ItIsNotImportant-02/VMix-Replay-Controller/docs/layout/evs-lsm-reference-photo.jpg

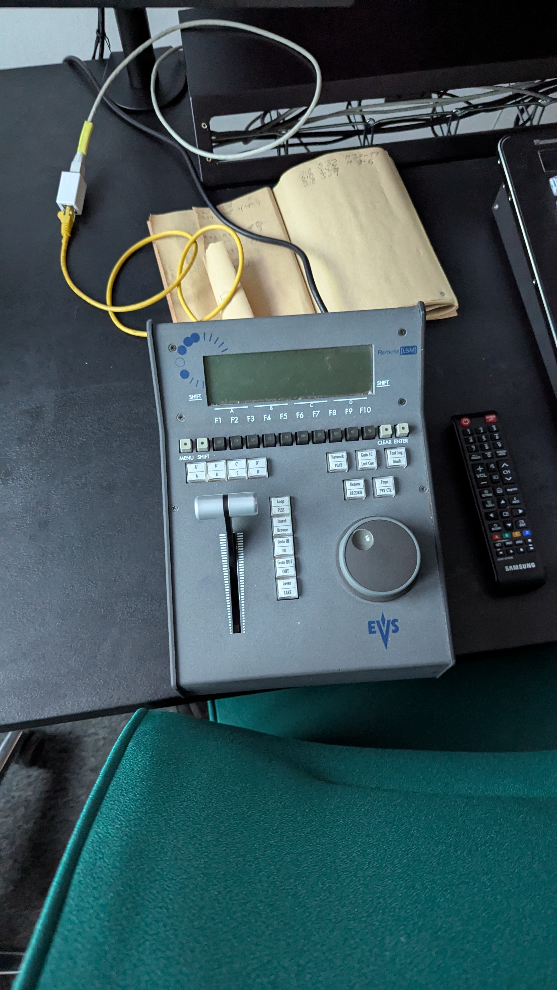
docs/layout/evs-lsm-reference-photo.jpg
