ItIsNotImportant-02/VMix-Replay-Controller/README.md

# vMix Replay Controller

Vlastní hardwarový ovladač pro vMix Replay ve stylu EVS: RGB tlačítka, páka pro rychlost, jog kolečko. Vlastní PCB (KiCad, osazení JLCPCB), vlastní firmware, 3D tištěná krabička.

- Plán projektu: [docs/PLAN.md](docs/PLAN.md)
- Dashboard postupu: https://claude.ai/artifact/F6eHfhQ5NSxDFNfWmzDA3g
- Deep Research prompty: [docs/research/](docs/research/)
