ItIsNotImportant-02/VMix-Replay-Controller/mechanics/README.md

# Mechanika

3D modely krabičky, mechanismu páky a jogu (STEP/STL), krok 9.x.
