ItIsNotImportant-02/VMix-Replay-Controller/firmware/README.md

# Firmware

Firmware pro RP2040 (W5500, IS31FL3236A, TCA9555, MT6701). Zatím prázdné; začne se prototypem na W5500-EVB-Pico (krok 7.1).
