ItIsNotImportant-02/VMix-Replay-Controller/docs/research/DR3-report-gemini.md

# **Advanced Hardware Architecture for a USB-C Broadcast Replay Controller**

## **Executive Summary**

The engineering of a broadcast-grade replay controller necessitates a rigorous focus on component latency, tactile feedback, signaling integrity, and strict power constraints. Operating within a strict 500 mA, 5 V USB-C power budget while driving \~45 independent LED channels, processing high-resolution quadrature feedback, and maintaining reliable TCP communication over Ethernet demands a highly optimized and mathematically verified hardware architecture.  
Based on extensive component analysis and the specific manufacturing capabilities of the JLCPCB Surface Mount Technology (SMT) assembly ecosystem, this report establishes a comprehensive design methodology for the printed circuit board (PCB) assembly. The recommended architecture leverages the Raspberry Pi RP2040 microcontroller1 for its maturity and predictable silicon behavior, intentionally bypassing the newer RP2350 due to unresolved hardware errata affecting GPIO inputs3. Ethernet connectivity is managed by the WIZnet W5500 over an 80 MHz SPI bus5, terminating in a HanRun HR911105A integrated magnetic RJ45 jack6 to minimize electromagnetic interference (EMI).  
For the human-machine interface, two ISSI IS31FL3236A constant-current LED drivers manage the common-anode RGB switches7, actively avoiding the camera-flicker and banding issues inherent in matrix-multiplexed topologies. Switch states are acquired via a TCA9555 I2C I/O expander, utilizing hardware interrupts to eliminate polling overhead and preserve CPU cycles8. Both the replay lever and the jog wheel employ the MT6701 contactless magnetic angle sensor10, providing 14-bit absolute accuracy and high-resolution ABZ quadrature outputs, drastically outperforming traditional optical encoders and the slower AS560011. Power is regulated by a robust AMS1117-3.3 linear low-dropout (LDO) regulator13, with the design strictly adhering to JLCPCB "Basic" and "Promotional Extended" components wherever possible to minimize feeder loading fees14.

## **1\. Microcontroller Subsystem: RP2040 vs. RP2350 Architecture**

The selection of the primary microcontroller unit (MCU) dictates the foundational architecture, software stack, peripheral allocation, and routing topology of the entire controller board. While both the Raspberry Pi RP2040 and its successor, the RP2350, offer exceptional Programmable I/O (PIO) capabilities, their silicon maturity, layout requirements, and current hardware bugs differ significantly.

### **1.1 Architectural and Performance Comparison**

The RP2040 (LCSC C2040) is a mature, dual-core ARM Cortex-M0+ processor operating at 133 MHz, equipped with 264 KB of SRAM2. It has been heavily adopted across the industry and is widely available at JLCPCB as a "Basic" component, meaning it incurs no \$3.07 feeder loading fee during assembly14.  
Conversely, the RP2350 (LCSC C39843328 for the QFN-80 package) offers a significant performance leap, featuring a dual-core Cortex-M33 architecture with an optional Hazard3 RISC-V core execution mode at 150 MHz1. The RP2350 doubles the internal SRAM to 520 KB and introduces a hardware Floating-Point Unit (FPU) alongside DSP-oriented instructions2. Both microcontrollers lack internal non-volatile application flash memory, necessitating an external Quad-SPI (QSPI) flash chip for code execution17.

| Feature / Specification | RP2040 (C2040) | RP2350 (C39843328) |
| :---- | :---- | :---- |
| **CPU Architecture** | Dual Cortex-M0+ @ 133 MHz | Dual Cortex-M33 / Hazard3 RISC-V @ 150 MHz |
| **Internal SRAM** | 264 KB | 520 KB |
| **Hardware FPU/DSP** | None (Software accelerated) | Single-precision FPU, DSP extensions |
| **Programmable I/O (PIO)** | 2 blocks, 8 state machines | 3 blocks, 12 state machines |
| **Advanced Security** | Basic | TrustZone, Secure Boot, OTP, TRNG |
| **JLCPCB Classification** | Basic (Highly Stocked, No Fee) | Extended (Subject to stock and \$3.07 fee) |
| **Silicon Maturity & Risk** | Fully patched, mature ecosystem | Susceptible to E9 GPIO Latching Erratum |

### **1.2 The E9 Erratum and Hardware Implications**

Despite the RP2350's superior computational headroom, early silicon revisions (including the A2 stepping) exhibit a critical hardware flaw documented as Erratum E93. This erratum involves increased leakage current when Bank 0 GPIO pads are enabled as digital inputs. The internal pull-down resistors (approximately 50 k$\Omega$) are too weak to overcome this leakage current, causing the pad voltage to artificially latch at approximately 2.0 V to 2.2 V4.  
For a broadcast controller reading numerous high-impedance switches, limit sensors, and external interrupts, reliable input states are mandatory. The E9 erratum forces hardware designers to either implement aggressive software workarounds—such as continuously toggling the GPIO input enable (IE) bit, temporarily disabling interrupts, and halting FreeRTOS task switching during every digital read—or to populate external physical pull-down resistors of 8.2 k$\Omega$ or lower on every affected input pin4.  
If the RP2350 were selected for this design, adding external pull-down resistors for the \~20 switch inputs and encoder channels would significantly increase the Bill of Materials (BOM) count, consume valuable PCB real estate, and inflate assembly costs.

### **1.3 External QSPI Flash and Support Circuitry**

Both MCUs execute code in place (XIP) via an external QSPI flash memory. The Winbond W25Q128JVSIQ (LCSC C97521) is an optimal choice, providing 128 Mbit (16 MB) of storage and supporting up to 133 MHz clock speeds25. To ensure stable boot sequences, a 10 k$\Omega$ pull-up resistor is required on the QSPI\_SS pin to prevent the MCU from dropping into USB mass storage bootloader mode erratically21.  
Timing accuracy for USB communication and PIO state machines relies on an external 12 MHz crystal oscillator (3225 package format, with 12 pF to 18 pF load capacitance)26.

### **1.4 Power Supply Topologies (LDO vs. Internal Regulators)**

The power supply architecture differs fundamentally between the two chips. The RP2040 features a built-in linear regulator that accepts 3.3 V and outputs the 1.1 V required for the internal digital core (DVDD)21. The RP2350, however, features a more complex five-pin internal switched-mode/linear regulator subsystem that requires specific external componentry, or alternatively, entirely bypassing it in favor of an external 1.1 V buck converter21.

### **1.5 Recommendation for Late 2026**

For a commercial design entering manufacturing in late 2026, the **RP2040 is the unequivocally recommended MCU**. The broadcast controller's processing requirements—primarily TCP offloading to the W5500, I2C polling, and PIO-based ABZ quadrature tracking—do not require Cortex-M33 DSP instructions or 520 KB of RAM. The RP2040 is a JLCPCB Basic part, guarantees predictable silicon behavior, avoids the BOM-bloat associated with the E9 erratum, and utilizes highly documented KiCad hardware minimal design references17.

## **2\. Ethernet Subsystem: WIZnet W5500 Integration**

Broadcast replay systems typically interface with software (such as vMix) or hardware switchers via local area networks. Reliable, low-latency TCP communication is mandatory. Relying on an MCU to handle software TCP/IP stacks (like lwIP) often introduces unpredictable latency spikes under heavy packet loads.

### **2.1 W5500 Architecture and SPI Direct Memory Access**

The WIZnet W5500 (LCSC C32843) is a hardwired TCP/IP embedded Ethernet controller that provides internet connection to embedded systems by utilizing a highly efficient Serial Peripheral Interface (SPI)27. It encapsulates the entire OSI model transport and network layers in silicon, supporting TCP, UDP, IPv4, ICMP, ARP, IGMP, and PPPoE27. It includes 32 KB of internal static RAM allocated for TX/RX buffering and supports up to 8 independent hardware sockets simultaneously27.  
Offloading the TCP/IP stack to the W5500 frees the RP2040 from managing packet fragmentation, ARP resolution, and TCP handshakes30. The SPI interface on the W5500 supports theoretical clock speeds up to 80 MHz5. To achieve minimal latency on TCP port 8099 (the standard communication port for vMix and similar broadcast APIs), the RP2040 should communicate with the W5500 using Direct Memory Access (DMA) over the SPI bus. Utilizing the RP2040's PIO state machines to drive the SPI interface further eliminates CPU bottlenecking during large packet transfers31.

### **2.2 RJ45 Magjack Integration**

Instead of routing discrete Ethernet transformers—which consume excessive PCB real estate and demand rigorous EMI shielding techniques—an integrated RJ45 magjack is highly recommended. The HanRun HR911105A (LCSC C12074) integrates the 1:1 isolation transformers, common-mode chokes, and link/activity LEDs required for 10/100Base-TX Ethernet directly into the connector housing6.

| Component Category | Recommended Part | LCSC Number | JLCPCB Classification | Estimated Function / Benefit |
| :---- | :---- | :---- | :---- | :---- |
| **Ethernet Controller** | WIZnet W5500 | C32843 | Extended | Hardwired TCP/IP, 32KB Buffer, 80MHz SPI |
| **Integrated Magjack** | HanRun HR911105A | C12074 | Extended | Built-in isolation magnetics, saves PCB space |
| **Clock Source** | 25.000 MHz Crystal | C521599 (varies) | Basic | Required for W5500 PHY PLL timing |
| **Termination Resistors** | 49.9  1% Resistors | Generic 0603/0402 | Basic | RX/TX pair impedance matching |

### **2.3 PCB Layout Guidelines and 100-Ohm Differential Impedance**

The physical layer (PHY) layout between the W5500 and the HR911105A is the most critical routing task on the board to ensure packet integrity. The Ethernet standard specifies a 100  differential impedance for the transmit (TX) and receive (RX) pairs33.

* **Routing Topology:** The differential pairs (TXP/TXN and RXP/RXN) must be routed symmetrically, edge-coupled, and strictly length-matched35. Any mismatch in trace length introduces phase shifts that degrade the differential signal into common-mode noise. Acute routing angles (less than 135 degrees) must be avoided to prevent signal reflection35.  
* **Reference Plane:** A solid, uninterrupted ground plane must exist directly beneath the entire length of the differential pairs on the adjacent internal or bottom layer to provide a predictable, low-impedance return path35.  
* **Clearance and Crosstalk:** Maintain a clearance of at least three times the inter-pair spacing (the "3W rule")—ideally 5X—between the Ethernet pairs and any high-speed digital lines (e.g., the SPI bus or QSPI traces) to prevent capacitive coupling and crosstalk35.  
* **Center Tap Filtering:** The W5500 PHY requires specific termination passive networks. The center tap of the RJ45 magnetics must be decoupled to ground via a 0.1 F capacitor, and the TX/RX pairs require 49.9  (1% tolerance) pull-up resistors to the 3.3 V analog supply rail (AVDD) to dissipate common-mode noise37.  
* **Clock Isolation:** The 25 MHz crystal required to drive the W5500's internal phase-locked loop (PLL) must be placed as close to the XTAL pins as possible. A dedicated ground guard ring should surround the crystal circuitry to prevent the 25 MHz fundamental frequency and its harmonics from coupling into the sensitive analog PHY traces38.

## **3\. Broadcast Tactile Interface: LED Driving Topology**

A replay controller relies heavily on visual feedback; buttons must illuminate brightly to indicate active cameras, recording states, and transition readiness. Driving \~15 SPDT push buttons featuring common-anode RGB LEDs results in \~45 discrete LED channels. The 5 V, 500 mA power budget strictly governs the driving topology and efficiency requirements.

### **3.1 Multiplexing vs. Constant-Current Direct Drive**

Traditional approaches to driving high-channel-count LEDs involve matrix multiplexing (e.g., IS31FL3731, IS31FL3741) or simple shift registers combined with current-limiting resistors (e.g., 74HC595). However, broadcast environments involve high-framerate, rolling-shutter cameras under studio lighting. Matrix multiplexing inherently relies on scanning rows and columns sequentially; if this scanning frequency beats against a broadcast camera's shutter speed or refresh rate, severe dark banding or flickering will be visible on the video feed.  
Furthermore, relying on simple shift registers with series resistors (or a PCA9685 paired with 45 external discrete transistors) results in massive BOM bloat, exorbitant assembly costs, and uneven brightness. Forward voltage () variations across different LED color batches mean that fixed resistors will yield unpredictable luminous intensity.  
A direct-drive, constant-current PWM topology is essential. Every LED cathode must be driven by a dedicated, unmultiplexed current sink operating at a high PWM frequency.

### **3.2 Component Comparison: LED Drivers**

| Driver IC | Topology | Channels | Interface | PWM Frequency / Resolution | Viability for Broadcast |
| :---- | :---- | :---- | :---- | :---- | :---- |
| **IS31FL3731/3741** | Matrix Multiplexed | 144 / 351 | I2C | Variable / 8-bit | **Poor:** Causes camera banding/flicker. |
| **74HC595 \+ Resistors** | Direct Voltage | 8 | SPI | Bit-banged MCU | **Poor:** 100% CPU usage, uneven brightness. |
| **PCA9685 \+ Transistors** | Direct Voltage | 16 | I2C | 1.5 kHz / 12-bit | **Poor:** Requires 45 external MOSFETs. |
| **TLC5947 / TLC5955** | Direct Constant Current | 24 / 48 | SPI | High / 12-bit to 16-bit | **Moderate:** High cost, often low stock at JLCPCB. |
| **IS31FL3236A** | Direct Constant Current | 36 | I2C | 22 kHz / 8-bit | **Excellent:** No flicker, minimal passives. |

### **3.3 The IS31FL3236A Architecture**

The ISSI IS31FL3236A (LCSC C246443) is the optimal choice for this architecture. It provides 36 independent constant-current channels, each with 8-bit (256-step) independent PWM duty-cycle control7. Most critically, the PWM frequency can be hard-set to 22 kHz, placing it well outside the audible spectrum (preventing ceramic capacitor "singing") and completely eliminating camera flicker, regardless of the camera's shutter angle7.  
To support 45 channels, two IS31FL3236A ICs are required in parallel (yielding a total capacity of 72 channels)7. Both ICs share the same I2C bus. The 7-bit I2C slave address is hardware-configured via the AD pin. Connecting the AD pin of IC1 to GND configures it to address 0x78, and connecting the AD pin of IC2 to VCC configures it to 0x7E7.

### **3.4 Thermal Dissipation and Efficiency Calculations**

Power dissipation within the LED driver is a direct function of the voltage drop across the internal constant-current sinks. The RGB LEDs possess differing forward voltages based on semiconductor bandgaps:

* Red LEDs:   
* Green/Blue LEDs: 

Given that the common anodes are tied directly to the 5.0 V USB VBUS supply (to avoid overloading the 3.3 V LDO), the driver IC must sink the remaining voltage internally to maintain constant current:

* Red Voltage Drop:   
* Green/Blue Voltage Drop: 

Assuming a conservative design target of 10 mA per color channel (which yields excellent brightness for modern LEDs without blinding the operator), the thermal power dissipation () per IC can be estimated. Assuming the 45 LEDs are split evenly (22 channels on IC1, 23 on IC2), IC1 will drive approximately 7 Red, 7 Green, and 8 Blue channels.   Total  per driver IC41.  
The QFN-44 (5x5 mm) package utilizes a large exposed thermal pad. To safely dissipate \~0.5 W and maintain junction temperatures well below the 125 °C absolute maximum, the PCB layout must feature a solid copper ground pour directly beneath the IC. This pad must be stitched with a 3x3 grid of thermal vias connecting the top layer to the internal and bottom ground planes, creating a highly efficient thermal exhaust path42.  
The global output current ceiling is established via a single external resistor () on pin 40\. According to the datasheet formula , selecting an  of 7.6 k$\Omega$ sets the maximum possible per-channel current to a safe 10 mA, ensuring that software bugs cannot accidentally command 38 mA and melt the plastic button housings40.

## **4\. Switch Acquisition and Debounce Strategy**

Reading 15 SPDT push buttons (utilizing the Common and Normally Open terminals), alongside auxiliary switches on the T-bar lever and jog wheel, requires tracking approximately 18 to 20 digital inputs.

### **4.1 Topology Comparison: GPIO, Matrix, and Expanders**

> 1. **Direct GPIO:** Connecting 20 switches directly to the RP2040 requires 20 pins. This exhausts the RP2040's GPIO budget, leaving insufficient pins for the QSPI flash, Ethernet SPI bus, I2C buses, and PIO encoder reading.  
> 2. **Diode Matrix:** A matrix reduces pin count (e.g., a 4x5 matrix requires only 9 pins) but demands 20 individual switching diodes (e.g., 1N4148W) to prevent ghosting when multiple buttons are pressed simultaneously44. This significantly inflates the BOM line items and JLCPCB assembly costs, while still requiring the CPU to continuously scan the matrix45.  
> 3. **Shift Registers:** The 74HC165 (LCSC C80696) is highly affordable and categorized as a Basic part46. However, shift registers lack interrupt capabilities. They require continuous CPU polling over SPI or bit-banging, wasting RP2040 cycles and introducing variable input latency.  
> 4. **I/O Expander:** I2C I/O expanders like the MCP23017 or TCA9555 offer 16 bits of remote I/O with dedicated hardware interrupt outputs8.

| Input Topology | Pin Count Required | CPU Overhead | Hardware Interrupt | JLCPCB Assembly Impact |
| :---- | :---- | :---- | :---- | :---- |
| **Direct GPIO** | 20 | Low | Yes | None (uses native MCU) |
| **Diode Matrix** | 9 | High (Constant scanning) | No | High (Adds 20 diodes to BOM) |
| **74HC165 Shift Register** | 4 (SPI) | High (Constant polling) | No | Low (Basic Part) |
| **TCA9555 I/O Expander** | 2 (I2C) \+ 1 (INT) | Very Low (Event-driven) | Yes | Moderate (Extended Part) |

### **4.2 The TCA9555 Interrupt Architecture**

The TCA9555 (LCSC C140277) is the superior architectural choice. By utilizing two TCA9555 ICs on the same I2C bus, 32 inputs are secured. The critical advantage of the TCA9555 is its hardware interrupt (INT) pin. The IC automatically drives the INT pin low whenever any input state changes across its ports8.  
Consequently, the RP2040 can remain completely idle regarding switch polling. It only initiates an I2C read when the hardware interrupt triggers, ensuring sub-millisecond reaction times to button presses—a strict necessity for a live broadcast controller triggering rapid video cuts9.  
Mechanical switches inherently exhibit contact bounce, which can last between 5 ms and 20 ms. While hardware RC filters (e.g., a 10 k$\Omega$ pull-up and a 100 nF capacitor to ground) provide perfect analog debouncing, they add 40 passive components to the BOM. A more efficient approach utilizes robust software debouncing algorithms within the RP2040 firmware, utilizing a non-blocking delayed-on/off state machine that filters any transitions faster than 15 ms49.

## **5\. Precision Lever Angle Sensing (T-Bar)**

Broadcast replay controllers utilize a heavily damped lever (often referred to as a T-bar) to control playback speed (e.g., from 0% to 100% slow motion). Historically, these relied on high-end carbon track potentiometers, which inevitably degrade over time due to mechanical friction. Contactless magnetic Hall-effect sensors provide infinite mechanical life and superior linearity.

### **5.1 Magnetic Sensor Comparison**

The two dominant market options for absolute magnetic angle sensing are the AMS AS5600 (LCSC C499458)11 and the MagnTek MT6701 (LCSC C3003196)50.

| Specification | AS5600 | MT6701 |
| :---- | :---- | :---- |
| **Technology** | Standard Hall-Effect | Differential Hall-Effect |
| **Resolution** | 12-bit (4,096 steps) | 14-bit (16,384 steps) |
| **Digital Interfaces** | I2C, PWM | I2C, SSI, ABZ Quadrature, PWM |
| **System Latency** | \~1.5 ms (I2C bound) | \< 5 s (Analog/SSI bound) |
| **Maximum Speed** | Limited | 55,000 RPM |
| **JLCPCB Cost (Est.)** | \~\$1.20 | \~\$0.76 |

While the AS5600 is ubiquitous in hobbyist applications, its 12-bit resolution and high I2C latency make it unsuitable for smooth, broadcast-grade interpolation11. Furthermore, multiple AS5600s share the exact same hardcoded I2C address, requiring hardware multiplexers if more than one is used on a bus52.  
The MT6701 calculates the absolute angle by utilizing two interleaved Wheatstone bridges mapped to an internal DSP unit, achieving a sub-5 s propagation delay12.

### **5.2 Sensor Mechanical Implementation**

For the T-bar lever, the MT6701 should be read over its high-speed SPI/SSI interface to guarantee minimal latency. The mechanical integration requires a diametrically magnetized disc magnet (commonly 6 mm diameter  2.5 mm thickness) mounted directly to the pivot shaft of the lever53.  
The MT6701 IC is placed on the PCB directly beneath the axis of the magnet. The air gap between the magnet face and the IC surface must be strictly maintained between 0.5 mm and 2.0 mm. This ensures the magnetic flux linkage remains within the operational window, avoiding sensor saturation (if too close) or low Signal-to-Noise Ratio resulting in angle jitter (if too far)53. Careful 3D CAD mechanical modeling of the controller chassis is required to ensure the enclosure naturally enforces this tolerance.

## **6\. Broadcast Jog Wheel Encoding**

The jog wheel is utilized to scrub through individual video frames backward and forward. A premium broadcast jog wheel must feel dense, possess high rotational inertia, and rotate infinitely without mechanical detents or friction.

### **6.1 Avoiding Optical Encoders**

Inexpensive optical encoders (e.g., 100–600 PPR models from AliExpress) rely on mechanical bearings and slotted acrylic discs. They are highly susceptible to dust ingress and internal friction, ruining the tactile feel over time. Premium optical encoders used in professional gear are excessively expensive, bulky, and difficult to source reliably through automated PCBA channels.

### **6.2 MT6701 ABZ Quadrature Configuration**

The MT6701 provides a brilliant architectural alternative by operating as a high-resolution, contactless incremental encoder12. When configured in ABZ mode, the MT6701 outputs standard incremental quadrature signals (Channel A and Channel B, 90 degrees out of phase, plus a Zero index pulse)12.  
The IC can be permanently programmed via its internal EEPROM to output up to 1024 Pulses Per Revolution (PPR)12. When firmware decodes all four edges (rising and falling on both A and B) of these signals, this yields exactly 4096 discrete steps per 360-degree rotation. The RP2040's unique PIO hardware state machines can effortlessly decode these quadrature signals in the background with absolute zero CPU overhead, storing the accumulated steps in a register for the main core to read at its leisure56.  
The mechanical design requires a heavy aluminum or weighted plastic knob attached to a metal shaft, supported by dual sealed ABEC-rated ball bearings within the chassis. A diametric magnet is affixed to the bottom of the shaft, hovering over a second MT6701 on the PCB. This topology guarantees flawless, friction-free tracking, enabling operators to achieve frame-accurate jogging without any mechanical wear to the sensor itself.

## **7\. USB-C Power Delivery and Signal Integrity**

The entire system is powered and programmed via a single USB-C interface. Because the device does not contain a battery and operates well under the baseline 5 V / 500 mA (2.5 W) USB limit, complex USB Power Delivery (USB-PD) negotiation chips (like the FUSB302) are unnecessary. A standard legacy 5 V / 3 A Type-C resistor implementation is completely sufficient.

### **7.1 USB-C Connector and Host Enumeration**

The Korean Hroparts TYPE-C-31-M-12 (LCSC C165948) is a 16-pin hybrid connector featuring SMT pads for electrical connections and THT tabs for physical shield mounting, providing excellent mechanical rigidity against cable torque. It is classified as a "Promotional Extended" part at JLCPCB, meaning it bypasses the \$3.07 feeder loading fee, minimizing assembly costs15.  
To ensure a standard USB host (such as a PC or a modern Type-C charger) provides 5 V on the VBUS pins, the CC1 and CC2 pins on the connector must each be independently pulled to GND via their own 5.1 k$\Omega$ (1%) resistor. Tying them together with a single resistor violates the USB specification and will cause the device to fail to power on when used with active "e-marked" cables.

### **7.2 ESD Protection and Overcurrent Safeguards**

Broadcast environments are highly prone to static electricity due to extensive cabling, carpets, and rapid movement. The STMicroelectronics USBLC6-2SC6 (LCSC C7519) transient voltage suppressor (TVS) diode array provides IEC 61000-4-2 Level 4 protection (15 kV air discharge, 8 kV contact discharge)59. Its ultra-low parasitic capacitance (3.5 pF max) ensures the USB 2.0 Full-Speed D+/D- data lines suffer no signal degradation or edge-rate distortion59. A 500 mA PTC resettable polyfuse must be placed in series with VBUS to protect the host PC from catastrophic failure in the event of an onboard short circuit.

### **7.3 Power Regulation (LDO vs. Buck)**

The RP2040, W5500, I/O expanders, and MT6701 sensors all require a 3.3 V logic supply. A linear low-dropout (LDO) regulator is preferred over a switching buck converter due to its lower cost, smaller footprint, and complete absence of high-frequency switching noise that could pollute the Ethernet PHY.  
The AMS1117-3.3 (LCSC C6186) is a heavily stocked Basic part capable of supplying 800 mA13. A current budget analysis yields the following estimates:

* **W5500 PHY/MAC:** \~130 mA (during 100 Mbps full-duplex transmission)  
* **RP2040 Core:** \~25 mA  
* **Flash \+ Sensors \+ Logic:** \~20 mA  
* **Total 3.3 V Load:** \~175 mA

The thermal dissipation within the LDO is calculated as . . The SOT-223 package of the AMS1117 possesses a thermal resistance () of \~60 °C/W on a standard PCB layout. A 0.3 W dissipation results in a mere 18 °C temperature rise above ambient, which is extremely safe and well within thermal limits13.

### **7.4 LED PWM Noise Filtering and OLED Integration**

The 45 LED channels operate directly from the 5 V VBUS rail to reduce thermal load on the LDO. The IS31FL3236A drivers will aggressively switch up to 450 mA of instantaneous current at 22 kHz. This rapid di/dt switching will create severe voltage ripples on the VBUS rail. To prevent this noise from backfeeding into the USB host or disrupting the 3.3 V logic LDO, the 5 V feed to the LED anodes must be isolated using an LC Pi-filter or a heavy ferrite bead (e.g., 600  at 100 MHz) paired with localized bulk decoupling capacitors (10 F to 47 F) placed physically close to the LED drivers.  
For timecode and status display, an optional OLED screen utilizing an SSD1306 controller can be integrated. These modules communicate over I2C and require only 4 pins (3.3 V, GND, SDA, SCL). They can easily share the primary I2C bus with the TCA9555 expanders and LED drivers, provided the trace capacitance remains within the I2C specification limit of 400 pF.

## **8\. JLCPCB Assembly Cost Estimation and BOM**

Optimizing a design for JLCPCB's ecosystem requires deeply understanding their automated assembly fee structure. In 2026, JLCPCB charges an \$8.18 setup fee for Economic PCBA, plus a \$1.53 stencil fee19.  
The critical variable in prototype runs is the "Feeder Loading Fee." Every unique "Extended" component incurs a \$3.07 fee because the tape-and-reel must be manually loaded onto the Yamaha Pick-and-Place machines by an operator14. "Basic" and "Promotional Extended" parts are permanently pre-loaded in the machines and incur no loading fee15.  
Economic PCBA only permits single-sided assembly58. All SMT components (MCU, ICs, passives) must be placed on the top layer. Through-Hole (THT) components (such as the RJ45 jack, USB-C shield pins, and the 15 push buttons) can be soldered manually by JLCPCB, which incurs a flat \$3.58 hand-soldering labor fee per order, plus a small per-joint fee19.

### **8.1 Preliminary Bill of Materials (BOM)**

The following table outlines the core integrated circuits and critical connectors required for the architecture, cross-referenced with LCSC part numbers, JLCPCB classification, and estimated unit pricing for a small prototype run.

| Subsystem | Component Description | LCSC Part \# | Classification | Qty / Board | Unit Price (Est. \$) |
| :---- | :---- | :---- | :---- | :---- | :---- |
| **MCU** | Raspberry Pi RP2040 (QFN-56) | C2040 | **Basic** | 1 | \$1.09 |
| **Flash** | Winbond 128 Mbit QSPI Flash | C97521 | Extended | 1 | \$0.93 |
| **Ethernet** | WIZnet W5500 TCP/IP MAC/PHY | C32843 | Extended | 1 | \$2.84 |
| **Magjack** | HanRun HR911105A RJ45 THT | C12074 | Extended | 1 | \$1.10 |
| **LED Driver** | ISSI IS31FL3236A (36-Channel) | C246443 | Extended | 2 | \$0.37 |
| **I/O Expander** | TI TCA9555 (16-bit I2C) | C140277 | Extended | 2 | \$0.45 |
| **Sensors** | MagnTek MT6701 (14-bit Hall) | C3003196 | Extended | 2 | \$0.76 |
| **USB-C** | Hroparts 16-pin Hybrid Receptacle | C165948 | **Promo Ext.** | 1 | \$0.17 |
| **ESD** | ST USBLC6-2SC6 TVS Array | C7519 | **Basic** | 1 | \$0.12 |
| **Power** | AMS1117-3.3 LDO (800 mA) | C6186 | **Basic** | 1 | \$0.08 |
| **Clocks** | 12 MHz & 25 MHz SMD Crystals | Varied | **Basic** | 2 | \~\$0.10 |

### **8.2 Assembly Cost Estimation (5 Boards)**

For a minimum order quantity of 5 prototype boards utilizing the Economic PCBA tier:

* **PCB Fabrication (FR4, 1.6mm):** \~\$2.00  
* **Economic Setup & Stencil:** \$9.7162  
* **Feeder Loading Fees:** 7 unique Extended parts  \$3.07 \= \$21.49  
* **Component Costs (per board):** \~\$11.00  5 \= \$55.00  
* **SMT Placement & THT Labor:** \~\$15.00  
* **Estimated Total (Excluding Shipping):** **\~\$103.20** for 5 fully assembled, ready-to-program prototype boards.

## **9\. Source List with URLs**

| Source ID | URL |
| :---- | :---- |
| 1 | https\://datasheet.lcsc.com/datasheet/pdf/7f40ef358423c77f721917b416e556f7.pdf |
| 4 | https\://news.sparkfun.com/11692 |
| 6 | https\://esp32.co.uk/rp2040-vs-rp2350-raspberry-pi-pico-vs-pico-2/ |
| 13 | https\://www\.lcsc.com/product-detail/C2040.html |
| 17 | https\://www\.lcsc.com/category/941.html |
| 18 | https\://www\.lcsc.com/product-detail/C39843328.html |
| 19 | https\://www\.lcsc.com/product-detail/C12074.html |
| 21 | https\://www\.lcsc.com/product-detail/C499458.html |
| 22 | https\://www\.lcsc.com/product-detail/C32843.html |
| 26 | https\://www\.lcsc.com/category/1599.html |
| 38 | https\://www\.lcsc.com/product-detail/C19711153.html |
| 40 | https\://www\.lcsc.com/product-detail/Position-Sensors\_Magn-Tek-MT6701CT-STD-R\_C3003196.html |
| 48 | https\://www\.lcsc.com/product-detail/C165948.html |
| 70 | https\://datasheet.lcsc.com/datasheet/pdf/7935197bddb8deeea95201ae83ce3777.pdf |
| 77 | https\://www\.lcsc.com/category/1155.html |
| 78 | https\://www\.lcsc.com/product-detail/Crystals\_TAITIEN-Elec-XXCCCLNANF-25-000000MHZ\_C521599.html |
| 79 | https\://www\.lcsc.com/product-detail/ESD-Protection-Devices\_STMicroelectronics-USBLC6-2SC6\_C7519.html |
| 81 | https\://forums.raspberrypi.com/viewtopic.php?t=375631 |
| 82 | https\://github.com/earlephilhower/arduino-pico/issues/2380 |
| 84 | https\://learn.adafruit.com/key-pad-matrix-scanning-in-circuitpython/raspberry-pi-rp2350-erratum-workarounds |
| 85 | https\://hackaday.com/2024/09/20/raspberry-pi-rp2350-e9-erratum-redefined-as-input-mode-leakage-current/ |
| 86 | https\://github.com/raspberrypi/pico-feedback/issues/401 |
| 90 | https\://productflo.io/error-index |
| 93 | https\://community.simplefoc.com/t/bldc-for-compact-cassette-like-mechanism-direct-drive/3806?page=2 |
| 99 | https\://docs.espressif.com/projects/esp-iot-solution/en/release-v2.0/esp-iot-solution-en-master.pdf |
| 112 | https\://www\.lcsc.com/category/980.html |
| 113 | https\://www\.lcsc.com/blog/ams1117-voltage-regulator-complete-guide/ |
| 114 | https\://www\.lcsc.com/category/1032.html |
| 115 | https\://www\.lcsc.com/product-detail/C97521.html |
| 117 | https\://www\.arduinolibraries.info/architectures/rp2040 |
| 126 | https\://jlcpcb.com/help/article/pcb-assembly-price |
| 127 | https\://jlcpcb.com/help/article/pcb-assembly-faqs |
| 128 | https\://www\.schemalyzer.com/en/blog/manufacturing/jlcpcb/jlcpcb-assembly-guide |
| 129 | https\://jlcpcb.com/blog/reduce-pcb-assembly-cost-prototype |
| 130 | https\://highway.hackclub.com/guides/JLC-cost-optimizing |
| 131 | https\://jlcpcb.com/parts/basic\_parts |
| 135 | https\://www\.lcsc.com/product-detail/C97521.html |
| 136 | https\://www\.lcsc.com/product-detail/NOR-FLASH\_Winbond-Elec-W25Q128JVSIQ\_C97521.html |
| 141 | https\://www\.ic-components.com/products/ISSI(Integrated-Silicon-Solution,Inc.)/IS31FL3236-TQLS2.jsp |
| 142 | https\://www\.ovaga.com/products/detail/is31lt3178-grls4-tr |
| 146 | https\://github.com/WIZnet-ioNIC/WIZnet-PICO-AWS-C |
| 147 | https\://www\.mouser.com/datasheet/3/939/1/W55RP20\_ds\_v100e.pdf |
| 148 | https\://www\.tme.eu/en/news/about-product/page/72258/building-iot-devices-with-wiznet-chips-and-modules/ |
| 149 | https\://docs.circuitpython.org/en/10.1.0/shared-bindings/rp2pio/ |
| 158 | https\://www\.mouser.com/datasheet/2/1534/IS31FL3237\_DS-3394770.pdf |
| 166 | https\://voltiq.ru/datasheets/MT6701.pdf |
| 167 | https\://community.simplefoc.com/t/mt6701-compatibility-question/5345 |
| 168 | https\://klipper.discourse.group/t/experiment-with-hall-effect-angle-sensors/1693 |
| 175 | https\://esphome.io/components/binary\_sensor/gpio/ |
| 177 | https\://gist.github.com/ericek111/91ee5ddaa1029dbb53ba204280b85547 |
| 183 | https\://esphome.io/components/binary\_sensor/ |
| 185 | https\://docs.wiznet.io/img/design\_guide/Wiznet%20Ethernet%20Design%20Guide\_ENG.pdf |
| 187 | https\://www\.reddit.com/r/PrintedCircuitBoard/comments/8hp0zl/w5500\_ethernet\_chip\_layout\_advicehelp/ |
| 188 | https\://manuals.plus/wiznet/w5100-ethernet-design-guide-manual |
| 190 | https\://electronics.stackexchange.com/questions/372956/w5500-ethernet-chip-layout-advice-help |
| 194 | https\://www\.lcsc.com/product-detail/C140277.html |
| 195 | https\://grafito.in/blog/retrofit-nema17-encoder-feedback/ |
| 198 | https\://www\.lumissil.com/assets/pdf/core/IS31FL3236A\_DS.pdf |
| 199 | https\://www\.lumissil.com/assets/pdf/support/app%20notes/AN-135%20IS31FL3236A%20WHITE%20GOOD%20APPLICATION.pdf |
| 202 | https\://www\.lcsc.com/product-detail/C246443.html |
| 208 | https\://jlcpcb.com/help/article/pcb-assembly-price |
| 210 | https\://techoverflow.net/2024/04/09/jlcpcb-pcba-assembly-price-overview/ |
| 212 | https\://www\.lcsc.com/product-detail/C466653.html |
| 213 | https\://pip.raspberrypi.com/documents/RP-008280-DS-hardware-design-with-rp2350.pdf |
| 216 | https\://esp32.co.uk/rp2040-vs-rp2350-raspberry-pi-pico-vs-pico-2/ |
| 220 | https\://github.com/WIZnet-ioNIC/WIZnet-PICO-C |

#### **Citovaná díla**

> 1. Seeed Studio XIAO RP2350 \- LCSC, [https\://datasheet.lcsc.com/datasheet/pdf/7f40ef358423c77f721917b416e556f7.pdf?productCode=C41882923](https://datasheet.lcsc.com/datasheet/pdf/7f40ef358423c77f721917b416e556f7.pdf?productCode=C41882923)  
> 2. A Technical Comparison of the RP2350 and RP2040 Chips, [https\://news.sparkfun.com/11692](https://news.sparkfun.com/11692)  
> 3. RP2350 Errata E9 \- Pull-down lock-up \- Raspberry Pi Forums, [https\://forums.raspberrypi.com/viewtopic.php?t=375631](https://forums.raspberrypi.com/viewtopic.php?t=375631)  
> 4. RP2350-E9 erratum: input pin can become latched at about \~2V, [https\://github.com/earlephilhower/arduino-pico/issues/2380](https://github.com/earlephilhower/arduino-pico/issues/2380)  
> 5. W55RP20 Datasheet \| Mouser, [https\://www\.mouser.com/datasheet/3/939/1/W55RP20\_ds\_v100e.pdf](https://www.mouser.com/datasheet/3/939/1/W55RP20_ds_v100e.pdf)  
> 6. HANRUN(Zhongshan HanRun Elec) HR911105A \- LCSC Electronics, [https\://www\.lcsc.com/product-detail/C12074.html](https://www.lcsc.com/product-detail/C12074.html)  
> 7. IS31FL3236A \- Lumissil Microsystems, [https\://www\.lumissil.com/assets/pdf/core/IS31FL3236A\_DS.pdf](https://www.lumissil.com/assets/pdf/core/IS31FL3236A_DS.pdf)  
> 8. UMW TCA9535/539/555 \- LCSC, [https\://datasheet.lcsc.com/datasheet/pdf/7935197bddb8deeea95201ae83ce3777.pdf?productCode=C42420609](https://datasheet.lcsc.com/datasheet/pdf/7935197bddb8deeea95201ae83ce3777.pdf?productCode=C42420609)  
> 9. GPIO Binary Sensor \- ESPHome \- Smart Home Made Simple, [https\://esphome.io/components/binary\_sensor/gpio/](https://esphome.io/components/binary_sensor/gpio/)  
> 10. MT6701CT-AKD-R \| Angle, Linear Position Measuring \| NOVOSENSE, [https\://www\.lcsc.com/product-detail/C19711153.html](https://www.lcsc.com/product-detail/C19711153.html)  
> 11. AS5600-ASOT \| Angle, Linear Position Measuring \| ams \- LCSC, [https\://www\.lcsc.com/product-detail/C499458.html](https://www.lcsc.com/product-detail/C499458.html)  
> 12. MT6701, [https\://voltiq.ru/datasheets/MT6701.pdf](https://voltiq.ru/datasheets/MT6701.pdf)  
> 13. AMS1117 Voltage Regulator Guide \- LCSC, [https\://www\.lcsc.com/blog/ams1117-voltage-regulator-complete-guide/](https://www.lcsc.com/blog/ams1117-voltage-regulator-complete-guide/)  
> 14. PCB Assembly FAQs \- JLCPCB, [https\://jlcpcb.com/help/article/pcb-assembly-faqs](https://jlcpcb.com/help/article/pcb-assembly-faqs)  
> 15. Basic Electronic Components for Fast PCB Assembly \- JLCPCB, [https\://jlcpcb.com/parts/basic\_parts](https://jlcpcb.com/parts/basic_parts)  
> 16. RP2040 \| Microcontrollers \| Raspberry Pi \- LCSC Electronics, [https\://www\.lcsc.com/product-detail/C2040.html](https://www.lcsc.com/product-detail/C2040.html)  
> 17. RP2040 vs RP2350: Is Raspberry Pi Pico 2 Worth It? (2026), [https\://esp32.co.uk/rp2040-vs-rp2350-raspberry-pi-pico-vs-pico-2/](https://esp32.co.uk/rp2040-vs-rp2350-raspberry-pi-pico-vs-pico-2/)  
> 18. Microcontrollers – Best Price, In Stock \| Embedded \- LCSC, [https\://www\.lcsc.com/category/941.html](https://www.lcsc.com/category/941.html)  
> 19. PCB Assembly Cost: What Does the Price Include? \- JLCPCB, [https\://jlcpcb.com/help/article/pcb-assembly-price](https://jlcpcb.com/help/article/pcb-assembly-price)  
> 20. Raspberry Pi RP2354B \- Microcontrollers \- LCSC Electronics, [https\://www\.lcsc.com/product-detail/C39843328.html](https://www.lcsc.com/product-detail/C39843328.html)  
> 21. Hardware design with RP2350 \| Raspberry Pi, [https\://pip.raspberrypi.com/documents/RP-008280-DS-hardware-design-with-rp2350.pdf](https://pip.raspberrypi.com/documents/RP-008280-DS-hardware-design-with-rp2350.pdf)  
> 22. Raspberry Pi RP2350-E9 Erratum Redefined As Input ... \- Hackaday, [https\://hackaday.com/2024/09/20/raspberry-pi-rp2350-e9-erratum-redefined-as-input-mode-leakage-current/](https://hackaday.com/2024/09/20/raspberry-pi-rp2350-e9-erratum-redefined-as-input-mode-leakage-current/)  
> 23. Raspberry Pi RP2350 E9 Erratum Workarounds \| Keypad and Matrix, [https\://learn.adafruit.com/key-pad-matrix-scanning-in-circuitpython/raspberry-pi-rp2350-erratum-workarounds](https://learn.adafruit.com/key-pad-matrix-scanning-in-circuitpython/raspberry-pi-rp2350-erratum-workarounds)  
> 24. RP2350-E9 Erratum: can get "stuck" at 2V state even without pulldown, [https\://github.com/raspberrypi/pico-feedback/issues/401](https://github.com/raspberrypi/pico-feedback/issues/401)  
> 25. W25Q128JVSIQ \| Memory \| Winbond \- LCSC Electronics, [https\://www\.lcsc.com/product-detail/C97521.html](https://www.lcsc.com/product-detail/C97521.html)  
> 26. Best Price, In Stock \| Crystals, Oscillators, Resonators \- LCSC, [https\://www\.lcsc.com/category/1155.html](https://www.lcsc.com/category/1155.html)  
> 27. W5500 \| Controllers \| WIZNET \- LCSC, [https\://www\.lcsc.com/product-detail/C32843.html](https://www.lcsc.com/product-detail/C32843.html)  
> 28. Controllers – Best Price, In Stock \| Interface \- LCSC Electronics, [https\://www\.lcsc.com/category/1599.html](https://www.lcsc.com/category/1599.html)  
> 29. WIZnet-PICO-C \- Ethernet Example for RP2040, RP2350 \- GitHub, [https\://github.com/WIZnet-ioNIC/WIZnet-PICO-C](https://github.com/WIZnet-ioNIC/WIZnet-PICO-C)  
> 30. Building IoT devices with WIZnet chips and modules \- Tme.eu, [https\://www\.tme.eu/en/news/about-product/page/72258/building-iot-devices-with-wiznet-chips-and-modules/](https://www.tme.eu/en/news/about-product/page/72258/building-iot-devices-with-wiznet-chips-and-modules/)  
> 31. GitHub \- WIZnet-ioNIC/WIZnet-PICO-AWS-C: AWS IoT SDK Example, [https\://github.com/WIZnet-ioNIC/WIZnet-PICO-AWS-C](https://github.com/WIZnet-ioNIC/WIZnet-PICO-AWS-C)  
> 32. rp2pio – Hardware interface to RP2 series' programmable IO (PIO, [https\://docs.circuitpython.org/en/10.1.0/shared-bindings/rp2pio/](https://docs.circuitpython.org/en/10.1.0/shared-bindings/rp2pio/)  
> 33. Wiznet Ethernet Design Guide\_ENG.pdf, [https\://docs.wiznet.io/img/design\_guide/Wiznet%20Ethernet%20Design%20Guide\_ENG.pdf](https://docs.wiznet.io/img/design_guide/Wiznet%20Ethernet%20Design%20Guide_ENG.pdf)  
> 34. Wiznet W5100 Ethernet Design Guide User Guide \- Manuals.plus, [https\://manuals.plus/wiznet/w5100-ethernet-design-guide-manual](https://manuals.plus/wiznet/w5100-ethernet-design-guide-manual)  
> 35. W5500 Ethernet Chip Layout Advice/Help : r/PrintedCircuitBoard, [https\://www\.reddit.com/r/PrintedCircuitBoard/comments/8hp0zl/w5500\_ethernet\_chip\_layout\_advicehelp/](https://www.reddit.com/r/PrintedCircuitBoard/comments/8hp0zl/w5500_ethernet_chip_layout_advicehelp/)  
> 36. W5500 Ethernet Chip Layout Advice/Help, [https\://electronics.stackexchange.com/questions/372956/w5500-ethernet-chip-layout-advice-help](https://electronics.stackexchange.com/questions/372956/w5500-ethernet-chip-layout-advice-help)  
> 37. Hardware Engineering Error Index \- ProductFlo.io, [https\://productflo.io/error-index](https://productflo.io/error-index)  
> 38. TAITIEN Elec XXCCCLNANF-25.000000MHZ \- LCSC Electronics, [https\://www\.lcsc.com/product-detail/Crystals\_TAITIEN-Elec-XXCCCLNANF-25-000000MHZ\_C521599.html](https://www.lcsc.com/product-detail/Crystals_TAITIEN-Elec-XXCCCLNANF-25-000000MHZ_C521599.html)  
> 39. ISSI IS31FL3236A-QFLS2-TR \- LED Drivers \- LCSC Electronics, [https\://www\.lcsc.com/product-detail/C246443.html](https://www.lcsc.com/product-detail/C246443.html)  
> 40. IS31FL3236A WHITE GOOD APPLICATION \- Lumissil, [https\://www\.lumissil.com/assets/pdf/support/app%20notes/AN-135%20IS31FL3236A%20WHITE%20GOOD%20APPLICATION.pdf](https://www.lumissil.com/assets/pdf/support/app%20notes/AN-135%20IS31FL3236A%20WHITE%20GOOD%20APPLICATION.pdf)  
> 41. IS31FL3237 \- Mouser Electronics, [https\://www\.mouser.com/datasheet/2/1534/IS31FL3237\_DS-3394770.pdf](https://www.mouser.com/datasheet/2/1534/IS31FL3237_DS-3394770.pdf)  
> 42. IS31FL3236-TQLS2 ISSI, Integrated Silicon Solution Inc \| IC, [https\://www\.ic-components.com/products/ISSI(Integrated-Silicon-Solution,Inc.)/IS31FL3236-TQLS2.jsp](https://www.ic-components.com/products/ISSI\(Integrated-Silicon-Solution,Inc.\)/IS31FL3236-TQLS2.jsp)  
> 43. IS31LT3178-GRLS4-TR \| Original stock,Price \- Ovaga Technologies, [https\://www\.ovaga.com/products/detail/is31lt3178-grls4-tr](https://www.ovaga.com/products/detail/is31lt3178-grls4-tr)  
> 44. High Diode 1N4148W \- LCSC Electronics, [https\://www\.lcsc.com/product-detail/C466653.html](https://www.lcsc.com/product-detail/C466653.html)  
> 45. JLCPCB Assembly: Complete Guide to PCB Assembly Service (2025), [https\://www\.schemalyzer.com/en/blog/manufacturing/jlcpcb/jlcpcb-assembly-guide](https://www.schemalyzer.com/en/blog/manufacturing/jlcpcb/jlcpcb-assembly-guide)  
> 46. Shift Registers – Best Price, In Stock \| Logic \- LCSC, [https\://www\.lcsc.com/category/980.html](https://www.lcsc.com/category/980.html)  
> 47. TCA9555RTWR \| I/O Expanders \| TI \- LCSC, [https\://www\.lcsc.com/product-detail/C140277.html](https://www.lcsc.com/product-detail/C140277.html)  
> 48. Firmware for the Chinese uSDR slim clone (longer body, small LCD, [https\://gist.github.com/ericek111/91ee5ddaa1029dbb53ba204280b85547](https://gist.github.com/ericek111/91ee5ddaa1029dbb53ba204280b85547)  
> 49. Binary Sensor Component \- ESPHome \- Smart Home Made Simple, [https\://esphome.io/components/binary\_sensor/](https://esphome.io/components/binary_sensor/)  
> 50. MT6701CT-STD-R \| Angle, Linear Position Measuring \| NOVOSENSE, [https\://www\.lcsc.com/product-detail/Position-Sensors\_Magn-Tek-MT6701CT-STD-R\_C3003196.html](https://www.lcsc.com/product-detail/Position-Sensors_Magn-Tek-MT6701CT-STD-R_C3003196.html)  
> 51. ESP-IoT-Solution User Guide \- Technical Documents, [https\://docs.espressif.com/projects/esp-iot-solution/en/release-v2.0/esp-iot-solution-en-master.pdf](https://docs.espressif.com/projects/esp-iot-solution/en/release-v2.0/esp-iot-solution-en-master.pdf)  
> 52. BLDC for Compact Cassette-like mechanism direct drive \- Page 2, [https\://community.simplefoc.com/t/bldc-for-compact-cassette-like-mechanism-direct-drive/3806?page=2](https://community.simplefoc.com/t/bldc-for-compact-cassette-like-mechanism-direct-drive/3806?page=2)  
> 53. How to Retrofit a Standard NEMA 17 Motor with Encoder Feedback, [https\://grafito.in/blog/retrofit-nema17-encoder-feedback/](https://grafito.in/blog/retrofit-nema17-encoder-feedback/)  
> 54. Experiment with hall effect angle sensors \- Klipper Discourse, [https\://klipper.discourse.group/t/experiment-with-hall-effect-angle-sensors/1693](https://klipper.discourse.group/t/experiment-with-hall-effect-angle-sensors/1693)  
> 55. MT6701 compatibility question \- SimpleFOC Community, [https\://community.simplefoc.com/t/mt6701-compatibility-question/5345](https://community.simplefoc.com/t/mt6701-compatibility-question/5345)  
> 56. Rp2040 \- Arduino Library List, [https\://www\.arduinolibraries.info/architectures/rp2040](https://www.arduinolibraries.info/architectures/rp2040)  
> 57. Korean Hroparts Elec TYPE-C-31-M-12 \- LCSC, [https\://www\.lcsc.com/product-detail/C165948.html](https://www.lcsc.com/product-detail/C165948.html)  
> 58. JLCPCB PCBA assembly price overview \- TechOverflow, [https\://techoverflow.net/2024/04/09/jlcpcb-pcba-assembly-price-overview/](https://techoverflow.net/2024/04/09/jlcpcb-pcba-assembly-price-overview/)  
> 59. st usblc6-2sc6 \- TVS Diodes \- LCSC Electronics, [https\://www\.lcsc.com/product-detail/ESD-Protection-Devices\_STMicroelectronics-USBLC6-2SC6\_C7519.html](https://www.lcsc.com/product-detail/ESD-Protection-Devices_STMicroelectronics-USBLC6-2SC6_C7519.html)  
> 60. Voltage Regulators \- Linear, Low Drop Out (LDO) Regulators, [https\://www\.lcsc.com/category/1032.html](https://www.lcsc.com/category/1032.html)  
> 61. JLCPCB Cost optimizing \- Highway: Custom Projects, [https\://highway.hackclub.com/guides/JLC-cost-optimizing](https://highway.hackclub.com/guides/JLC-cost-optimizing)  
> 62. How to Reduce Prototype PCB Assembly Cost (With Real Quotes), [https\://jlcpcb.com/blog/reduce-pcb-assembly-cost-prototype](https://jlcpcb.com/blog/reduce-pcb-assembly-cost-prototype)

[image1]: <>

[image2]: <>

[image3]: <>

[image4]: <>

[image5]: <>

[image6]: <>

[image7]: <>

[image8]: <>

[image9]: <>

[image10]: <>

[image11]: <>

[image12]: <>

[image13]: <>

[image14]: <>

[image15]: <>

[image16]: <>

[image17]: <>
