ItIsNotImportant-02/VMix-Replay-Controller/hardware/PINMAP.md

# Přiřazení pinů (generováno z tools/circuit.py, needitovat ručně)

## RP2040 GPIO

| GPIO | Síť |
|---|---|
| GP0 | `UART_TX` |
| GP1 | `UART_RX` |
| GP2 | `JOG_DO` |
| GP3 | `JOG_CLK` |
| GP4 | `JOG_CSN` |
| GP5 | `JOG_MODE` |
| GP6 | `I2C_SDA` |
| GP7 | `I2C_SCL` |
| GP8 | `LED_SDB` |
| GP9 | `BTN_INT` |
| GP10 | `GP10` |
| GP11 | `GP11` |
| GP12 | `LEV_DO` |
| GP13 | `LEV_CSN` |
| GP14 | `LEV_CLK` |
| GP15 | `LEV_MODE` |
| GP16 | `ETH_MISO` |
| GP17 | `ETH_CS` |
| GP18 | `ETH_SCK` |
| GP19 | `ETH_MOSI` |
| GP20 | `ETH_RST` |
| GP21 | `ETH_INT` |
| GP22 | `GP22` |
| GP23 | `GP23` |
| GP24 | `GP24` |
| GP25 | `STATUS_LED` |
| GP26 | `LEV_OUT` |
| GP27 | `JOG_OUT` |
| GP28 | `GP28` |
| GP29 | `VSENSE_5V` |

## Tlačítka → TCA9555

| Tlačítko | Expandér | Port |
|---|---|---|
| MENU | U8 (0x20) | P00 |
| SHIFT | U8 (0x20) | P01 |
| CAM_A | U8 (0x20) | P02 |
| CAM_B | U8 (0x20) | P03 |
| CAM_C | U8 (0x20) | P04 |
| CAM_D | U8 (0x20) | P05 |
| PLST | U8 (0x20) | P06 |
| BROWSE | U8 (0x20) | P07 |
| IN | U8 (0x20) | P10 |
| OUT | U8 (0x20) | P11 |
| TAKE | U8 (0x20) | P12 |
| F1 | U8 (0x20) | P13 |
| F2 | U8 (0x20) | P14 |
| F3 | U8 (0x20) | P15 |
| F4 | U8 (0x20) | P16 |
| F5 | U8 (0x20) | P17 |
| CLEAR | U9 (0x21) | P00 |
| ENTER | U9 (0x21) | P01 |
| PLAY | U9 (0x21) | P02 |
| LAST_CUE | U9 (0x21) | P03 |
| MARK | U9 (0x21) | P04 |
| RECORD | U9 (0x21) | P05 |
| PRV_CTL | U9 (0x21) | P06 |
| F6 | U9 (0x21) | P07 |
| F7 | U9 (0x21) | P10 |
| F8 | U9 (0x21) | P11 |
| F9 | U9 (0x21) | P12 |
| F10 | U9 (0x21) | P13 |
| (volné, na J3) | U9 (0x21) | P14 |
| (volné, na J3) | U9 (0x21) | P15 |
| (volné, na J3) | U9 (0x21) | P16 |
| (volné, na J3) | U9 (0x21) | P17 |

## LED → IS31FL3236A

| LED | Budič | Kanál |
|---|---|---|
| MENU_R | U6 (0x3C) | OUT1 |
| MENU_G | U6 (0x3C) | OUT2 |
| MENU_B | U6 (0x3C) | OUT3 |
| SHIFT_R | U6 (0x3C) | OUT4 |
| SHIFT_G | U6 (0x3C) | OUT5 |
| SHIFT_B | U6 (0x3C) | OUT6 |
| CAM_A_R | U6 (0x3C) | OUT7 |
| CAM_A_G | U6 (0x3C) | OUT8 |
| CAM_A_B | U6 (0x3C) | OUT9 |
| CAM_B_R | U6 (0x3C) | OUT10 |
| CAM_B_G | U6 (0x3C) | OUT11 |
| CAM_B_B | U6 (0x3C) | OUT12 |
| CAM_C_R | U6 (0x3C) | OUT13 |
| CAM_C_G | U6 (0x3C) | OUT14 |
| CAM_C_B | U6 (0x3C) | OUT15 |
| CAM_D_R | U6 (0x3C) | OUT16 |
| CAM_D_G | U6 (0x3C) | OUT17 |
| CAM_D_B | U6 (0x3C) | OUT18 |
| PLST_R | U6 (0x3C) | OUT19 |
| PLST_G | U6 (0x3C) | OUT20 |
| PLST_B | U6 (0x3C) | OUT21 |
| BROWSE_R | U6 (0x3C) | OUT22 |
| BROWSE_G | U6 (0x3C) | OUT23 |
| BROWSE_B | U6 (0x3C) | OUT24 |
| IN_R | U6 (0x3C) | OUT25 |
| IN_G | U6 (0x3C) | OUT26 |
| IN_B | U6 (0x3C) | OUT27 |
| OUT_R | U6 (0x3C) | OUT28 |
| OUT_G | U6 (0x3C) | OUT29 |
| OUT_B | U6 (0x3C) | OUT30 |
| TAKE_R | U6 (0x3C) | OUT31 |
| TAKE_G | U6 (0x3C) | OUT32 |
| TAKE_B | U6 (0x3C) | OUT33 |
| CLEAR_R | U7 (0x3F) | OUT1 |
| CLEAR_G | U7 (0x3F) | OUT2 |
| CLEAR_B | U7 (0x3F) | OUT3 |
| ENTER_R | U7 (0x3F) | OUT4 |
| ENTER_G | U7 (0x3F) | OUT5 |
| ENTER_B | U7 (0x3F) | OUT6 |
| PLAY_R | U7 (0x3F) | OUT7 |
| PLAY_G | U7 (0x3F) | OUT8 |
| PLAY_B | U7 (0x3F) | OUT9 |
| LAST_CUE_R | U7 (0x3F) | OUT10 |
| LAST_CUE_G | U7 (0x3F) | OUT11 |
| LAST_CUE_B | U7 (0x3F) | OUT12 |
| MARK_R | U7 (0x3F) | OUT13 |
| MARK_G | U7 (0x3F) | OUT14 |
| MARK_B | U7 (0x3F) | OUT15 |
| RECORD_R | U7 (0x3F) | OUT16 |
| RECORD_G | U7 (0x3F) | OUT17 |
| RECORD_B | U7 (0x3F) | OUT18 |
| PRV_CTL_R | U7 (0x3F) | OUT19 |
| PRV_CTL_G | U7 (0x3F) | OUT20 |
| PRV_CTL_B | U7 (0x3F) | OUT21 |
| F1 | U7 (0x3F) | OUT22 |
| F2 | U7 (0x3F) | OUT23 |
| F3 | U7 (0x3F) | OUT24 |
| F4 | U7 (0x3F) | OUT25 |
| F5 | U7 (0x3F) | OUT26 |
| F6 | U7 (0x3F) | OUT27 |
| F7 | U7 (0x3F) | OUT28 |
| F8 | U7 (0x3F) | OUT29 |
| F9 | U7 (0x3F) | OUT30 |
| F10 | U7 (0x3F) | OUT31 |
