ItIsNotImportant-02/VMix-Replay-Controller/docs/layout/panel-layout-v0.6.pdf

USB-C (horní strana) | RJ45 (spodní strana)

vMix Replay Controller · layout v0.6 podle EVS LSM VIA · deska 160 × 155 mm · 1:1 (tisk 100 %) · zadní hrana

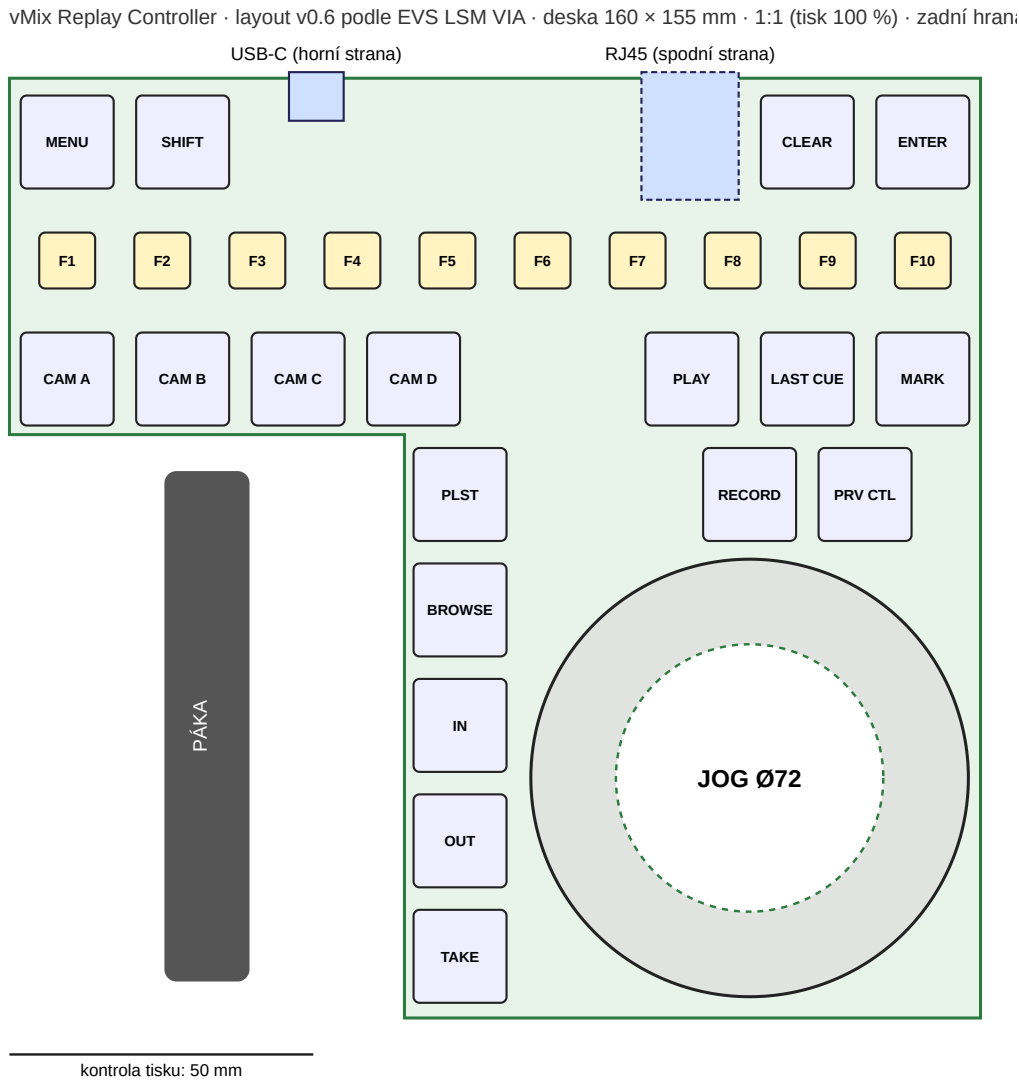
[picture p2: page 1]
JOG Ø72; MENU; SHIFT; CLEAR; ENTER; CAM A; CAM B; CAM C; CAM D; PLAY; LAST CUE; MARK; PLST; RECORD; PRV CTL; BROWSE; OUT; TAKE

kontrola tisku: 50 mm
