ItIsNotImportant-02/VMix-Replay-Controller/docs/layout/panel-layout-v0.5.pdf

## vMix Replay Controller · layout v0.5 podle EVS LSM · 1:1 (tisk 100 %) · bez displeje

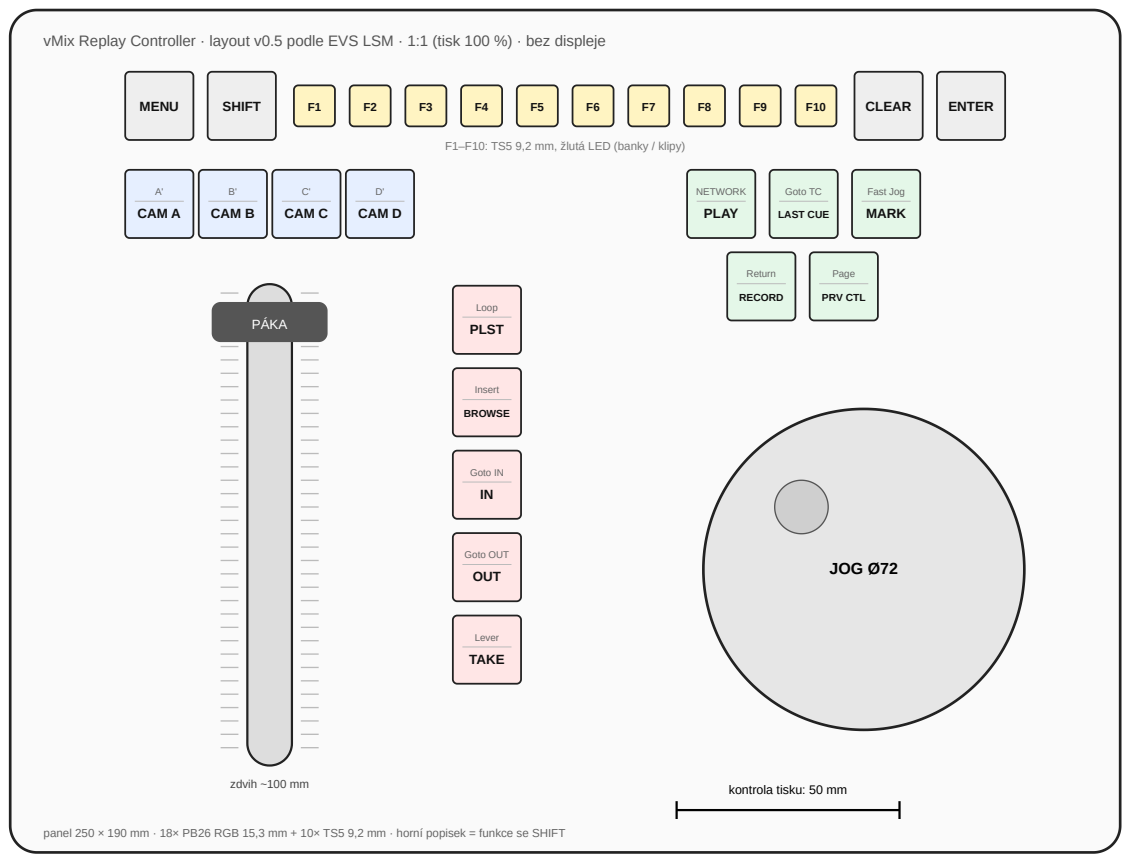
[picture p3: page 1]
MENU; SHIFT; CLEAR; ENTER; A' CAM A; B' CAM B; C' CAM C; D' CAM D; Loop PLST; Insert; BROWSE; Goto IN IN; Goto OUT OUT; Lever TAKE; NETWORK PLAY; Goto TC; LAST CUE; Fast Jog MARK; Return; RECORD; Page; PRV CTL; PÁKA; zdvih ~100 mm; JOG Ø72

F1–F10: TS5 9,2 mm, žlutá LED (banky / klipy)

kontrola tisku: 50 mm

panel 250 × 190 mm · 18× PB26 RGB 15,3 mm + 10× TS5 9,2 mm · horní popisek = funkce se SHIFT
