ItIsNotImportant-02/VMix-Replay-Controller/docs/layout/panel-layout-v0.2.pdf

## vMix Replay Controller · layout v0.2 podle EVS LSM · 1:1 (tisk 100 %) · bez displeje

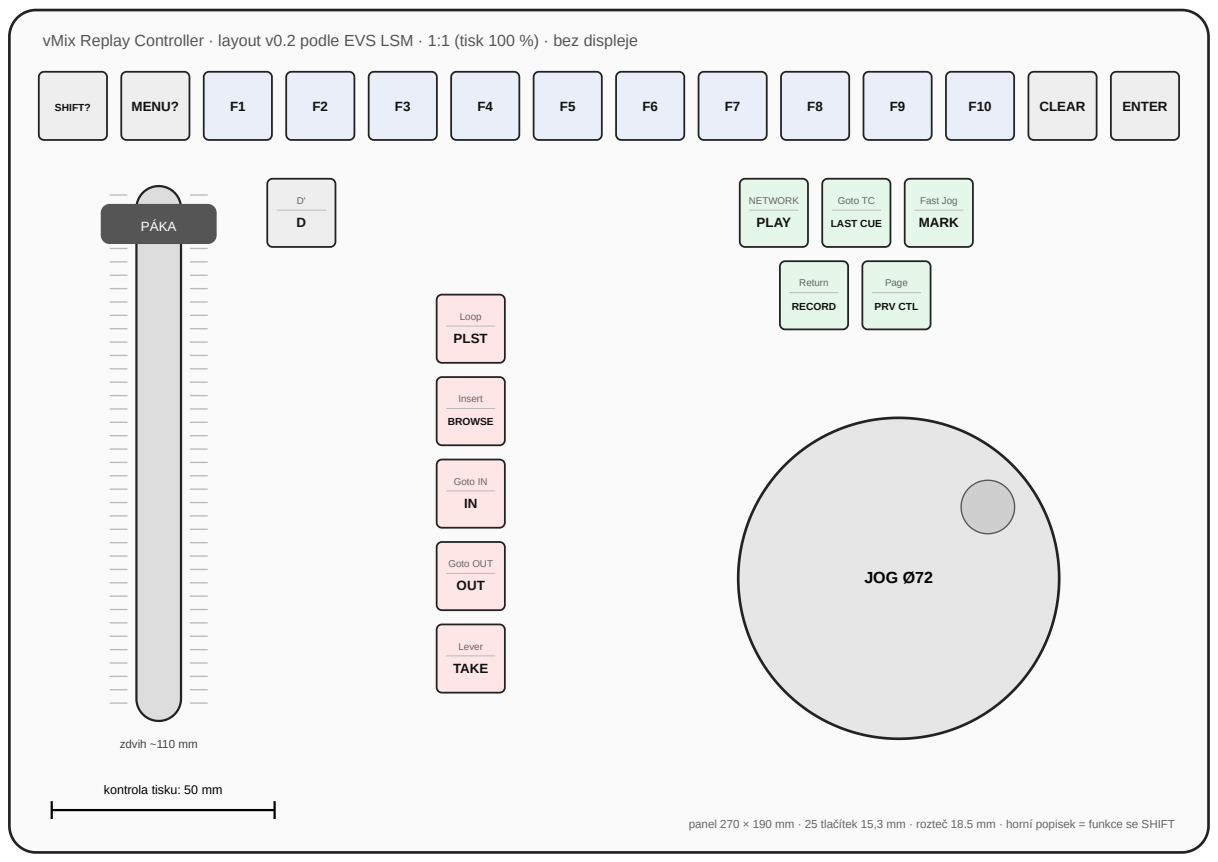
[picture p4: page 1]
SHIFT?; MENU?; CLEAR; ENTER; Loop PLST; Insert; BROWSE; Goto IN IN; Goto OUT OUT; Lever TAKE; NETWORK PLAY; Goto TC; LAST CUE; Fast Jog MARK; Return; RECORD; Page; PRV CTL; PÁKA; zdvih ~110 mm; JOG Ø72

kontrola tisku: 50 mm

panel 270 × 190 mm · 25 tlačítek 15,3 mm · rozteč 18.5 mm · horní popisek = funkce se SHIFT
