ItIsNotImportant-02/VMix-Replay-Controller/docs/layout/panel-layout-v0.1.pdf

## vMix Replay Controller · layout v0.1 · měřítko 1:1 (tisk 100 %, bez přizpůsobení)

### CAM 1 CAM 2

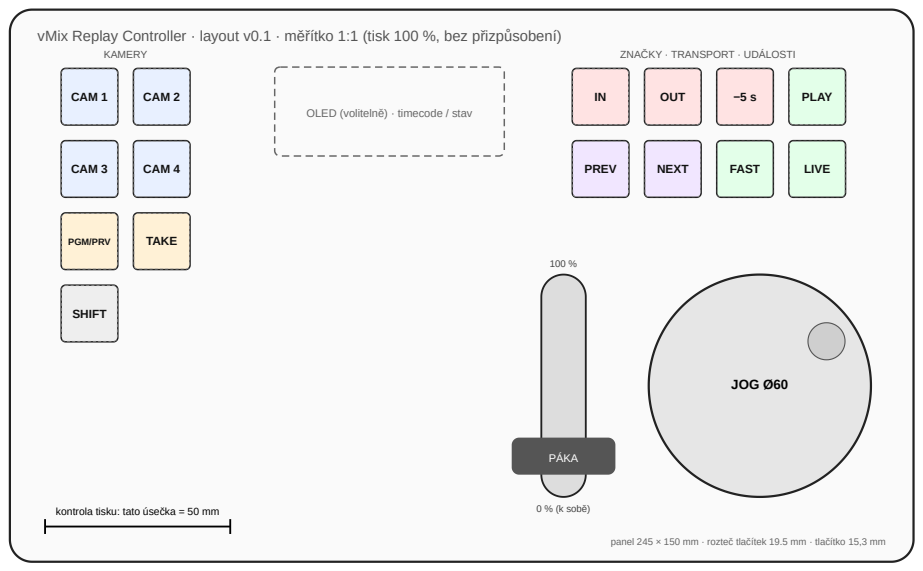
[picture p5: page 1]
CAM 3; CAM 4; PGM/PRV; TAKE; SHIFT; OUT; PLAY; PREV; NEXT; FAST; LIVE; PÁKA; 0 % (k sobě); JOG Ø60; KAMERY; ZNAČKY · TRANSPORT · UDÁLOSTI

OLED (volitelně) · timecode / stav

kontrola tisku: tato úsečka = 50 mm

panel 245 × 150 mm · rozteč tlačítek 19.5 mm · tlačítko 15,3 mm
