ItIsNotImportant-02/VMix-Replay-Controller/hardware/vmix-replay-controller.kicad_pcb

## KiCad design hardware/vmix-replay-controller.kicad_pcb (2026-11-12)

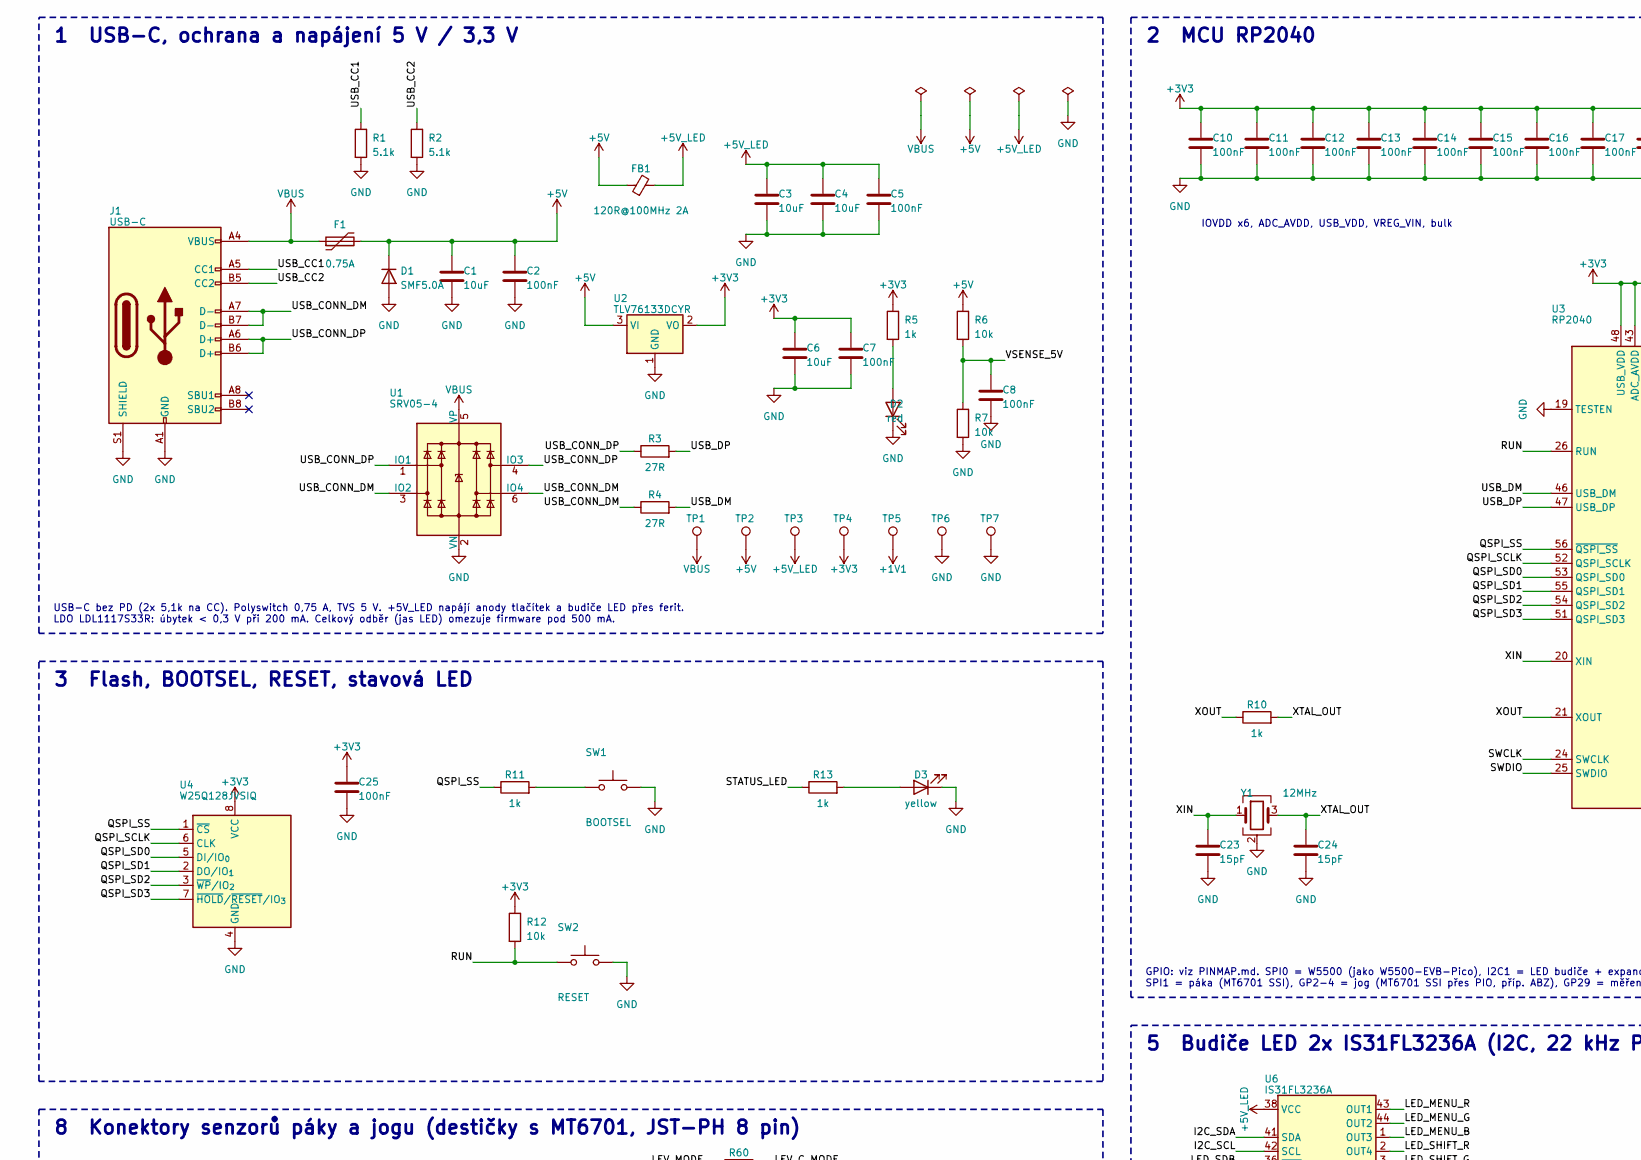
[picture p6: schematic vmix-replay-controller.kicad_sch, vMix Replay Controller - hlavní deska, part in row 1, column 1]

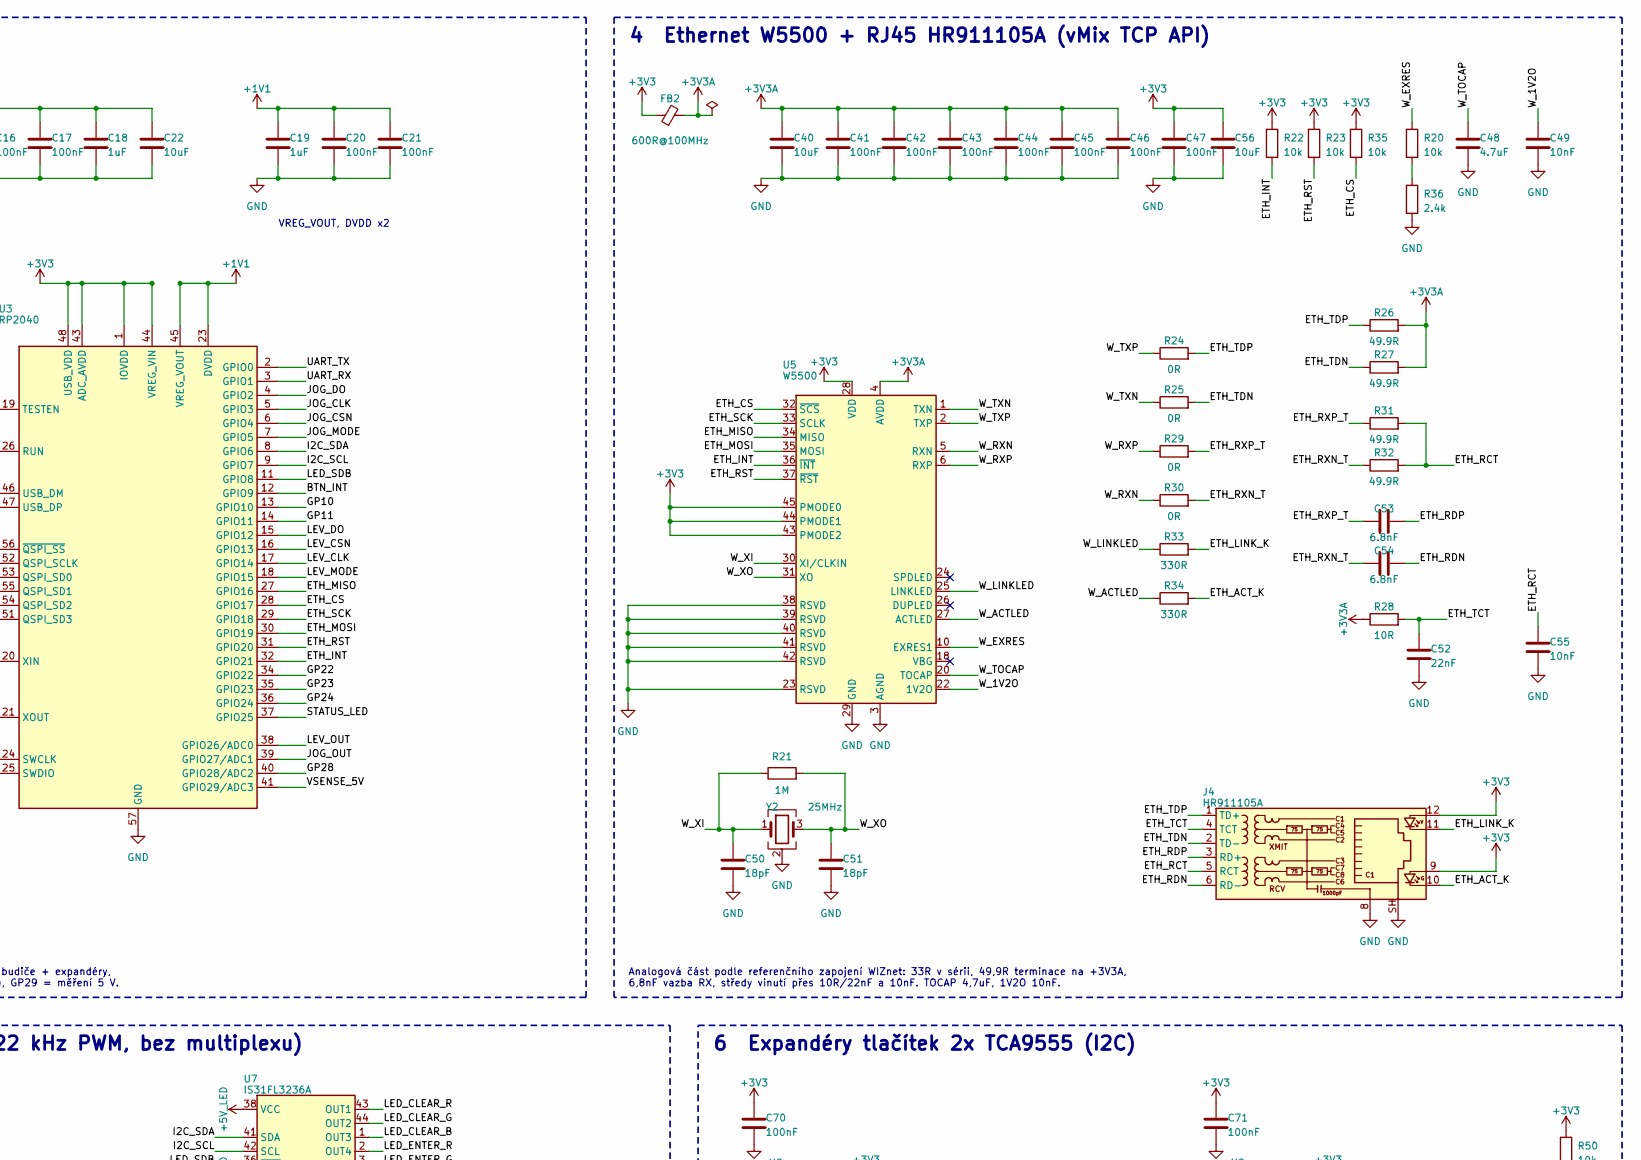
[picture p7: schematic vmix-replay-controller.kicad_sch, vMix Replay Controller - hlavní deska, part in row 1, column 2]

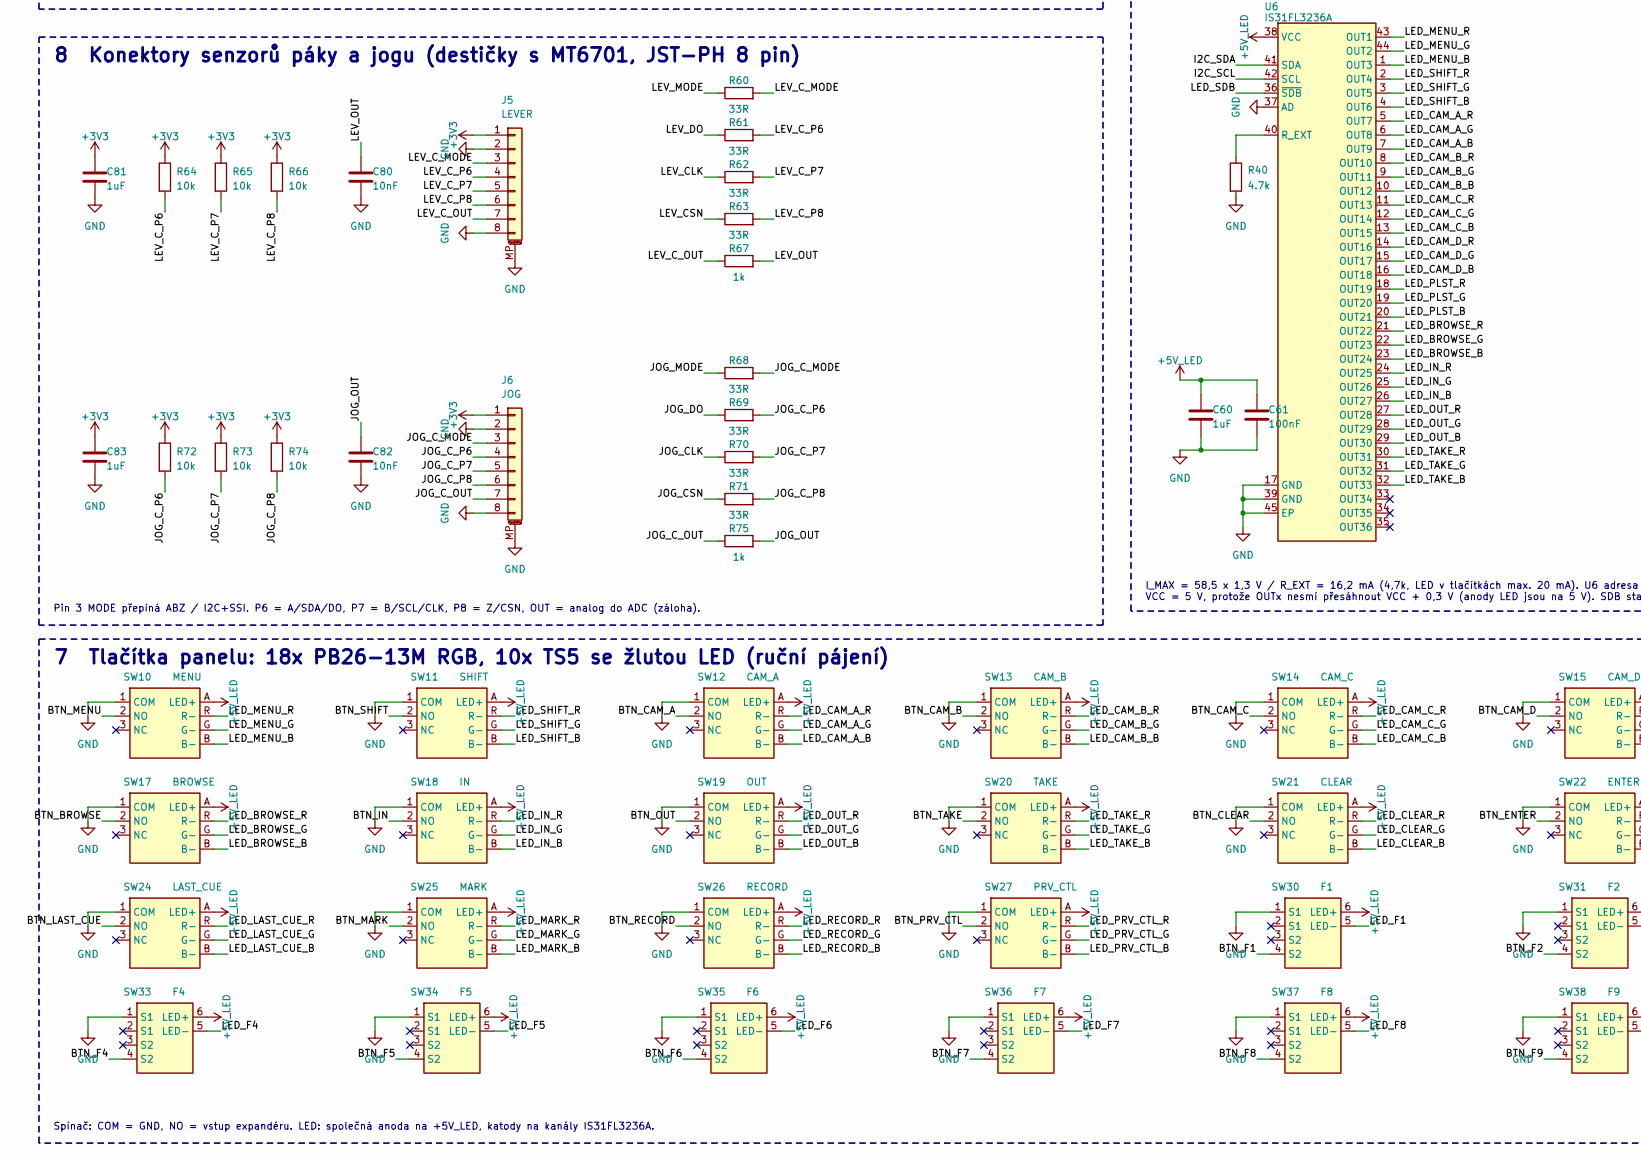
[picture p8: schematic vmix-replay-controller.kicad_sch, vMix Replay Controller - hlavní deska, part in row 2, column 1]

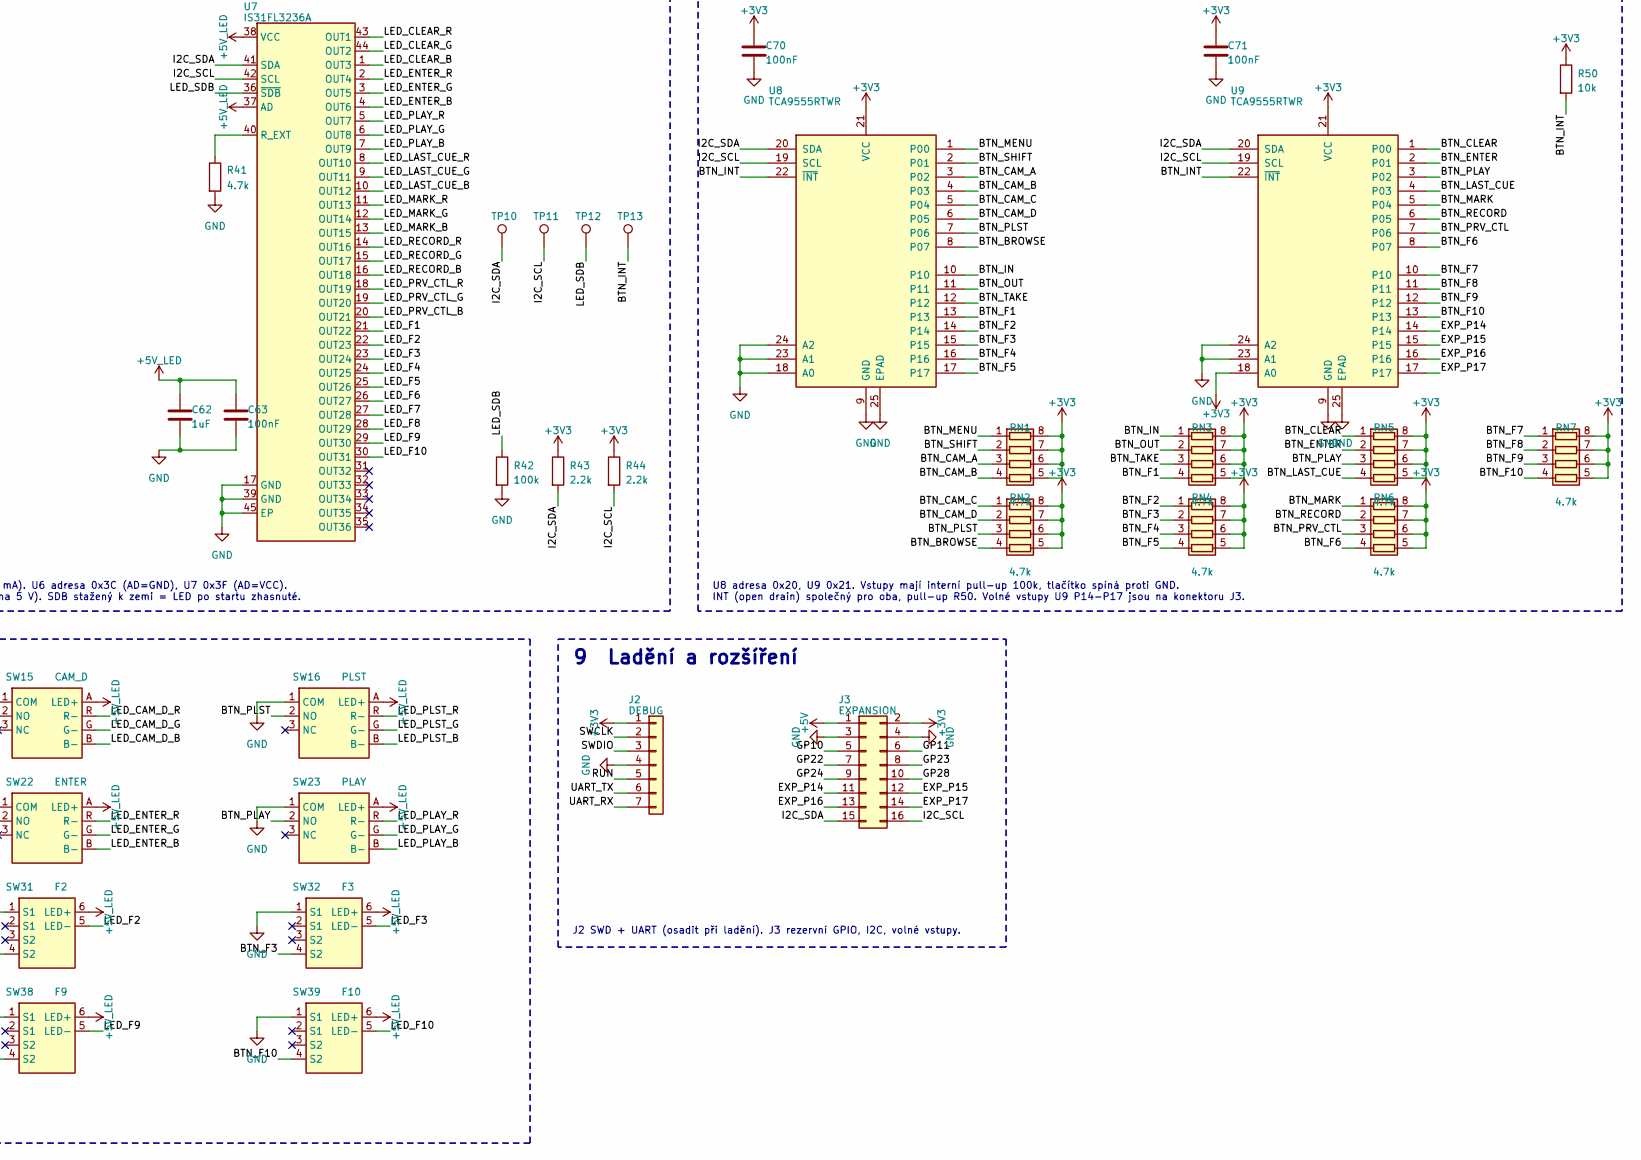
[picture p9: schematic vmix-replay-controller.kicad_sch, vMix Replay Controller - hlavní deska, part in row 2, column 2]

Parts:
C1, C3, C4, C6, C22, C40, C56: 10uF; C_0805_2012Metric; LCSC C15850
C2, C5, C7, C8, C10, C11, C12, C13, C14, C15, C16, C17, C20, C21, C25, C41, C42, C43, C44, C45, C46, C47, C61, C63, C70, C71: 100nF; C_0603_1608Metric; LCSC C14663
C18, C19, C60, C62, C81, C83: 1uF; C_0603_1608Metric; LCSC C15849
C23, C24: 15pF; C_0603_1608Metric; LCSC C1644
C48: 4.7uF; C_0603_1608Metric; LCSC C19666
C49, C55, C80, C82: 10nF; C_0603_1608Metric; LCSC C57112
C50, C51: 18pF; C_0603_1608Metric; LCSC C1647
C52: 22nF; C_0603_1608Metric; LCSC C21122
C53, C54: 6.8nF; C_0603_1608Metric; LCSC C1631
D1: SMF5.0A; D_SOD-123F; MPN hongjiacheng SMF5.0A; LCSC C19077497
D2: red; LED_0603_1608Metric; MPN KENTO KT-0603R; LCSC C2286
D3: yellow; LED_0603_1608Metric; MPN NationStar NCD0603Y2; LCSC C89811
F1: 0.75A; Fuse_1206_3216Metric; MPN JK-nSMD075/6V; LCSC C2830242
FB1: 120R@100MHz 2A; L_0603_1608Metric; MPN BLM18PG121SN1D; LCSC C14709
FB2: 600R@100MHz; L_0805_2012Metric; LCSC C1017
J1: USB-C; USB_C_Receptacle_HRO_TYPE-C-31-M-12; MPN TYPE-C-31-M-12; LCSC C165948
J2: DEBUG; PinHeader_1x07_P2.54mm_Vertical
J3: EXPANSION; PinHeader_2x08_P2.54mm_Vertical
J4: HR911105A; RJ45_Hanrun_HR911105A_Horizontal; LCSC C12074
J5: LEVER; JST_PH_S8B-PH-SM4-TB_1x08-1MP_P2.00mm_Horizontal; MPN S8B-PH-SM4-TB; LCSC C265121
J6: JOG; JST_PH_S8B-PH-SM4-TB_1x08-1MP_P2.00mm_Horizontal; MPN S8B-PH-SM4-TB; LCSC C265121
R1, R2: 5.1k; R_0603_1608Metric; Tolerance 1%; LCSC C23186
R3, R4: 27R; R_0603_1608Metric; Tolerance 1%; LCSC C25190
R5, R10, R11, R13, R67, R75: 1k; R_0603_1608Metric; Tolerance 1%; LCSC C21190
R6, R7, R12, R20, R22, R23, R35, R50, R64, R65, R66, R72, R73, R74: 10k; R_0603_1608Metric; Tolerance 1%; LCSC C25804
R21: 1M; R_0603_1608Metric; Tolerance 1%; LCSC C22935
R24, R25, R29, R30: 0R; R_0603_1608Metric; Tolerance 1%; LCSC C21189
R26, R27, R31, R32: 49.9R; R_0603_1608Metric; Tolerance 1%; LCSC C23185
R28: 10R; R_0603_1608Metric; Tolerance 1%; LCSC C22859
R33, R34: 330R; R_0603_1608Metric; Tolerance 1%; LCSC C23138
R36: 2.4k; R_0603_1608Metric; Tolerance 1%; LCSC C22940
R40, R41: 4.7k; R_0603_1608Metric; Tolerance 1%; LCSC C23162
R42: 100k; R_0603_1608Metric; Tolerance 1%; LCSC C25803
R43, R44: 2.2k; R_0603_1608Metric; Tolerance 1%; LCSC C4190
R60, R61, R62, R63, R68, R69, R70, R71: 33R; R_0603_1608Metric; Tolerance 1%; LCSC C23140
RN1, RN2, RN3, RN4, RN5, RN6, RN7: 4.7k; R_Array_Convex_4x0603; MPN 4D03WGJ0472T5E; LCSC C1980
SW1: BOOTSEL; SW_Push_1P1T_XKB_TS-1187A; LCSC C318884
SW2: RESET; SW_Push_1P1T_XKB_TS-1187A; LCSC C318884
SW10: MENU; PB26-13M-RGB; MPN PB26-13M-B-WT-RGB-N
SW11: SHIFT; PB26-13M-RGB; MPN PB26-13M-B-WT-RGB-N
SW12: CAM_A; PB26-13M-RGB; MPN PB26-13M-B-WT-RGB-N
SW13: CAM_B; PB26-13M-RGB; MPN PB26-13M-B-WT-RGB-N
SW14: CAM_C; PB26-13M-RGB; MPN PB26-13M-B-WT-RGB-N
SW15: CAM_D; PB26-13M-RGB; MPN PB26-13M-B-WT-RGB-N
SW16: PLST; PB26-13M-RGB; MPN PB26-13M-B-WT-RGB-N
SW17: BROWSE; PB26-13M-RGB; MPN PB26-13M-B-WT-RGB-N
SW18: IN; PB26-13M-RGB; MPN PB26-13M-B-WT-RGB-N
SW19: OUT; PB26-13M-RGB; MPN PB26-13M-B-WT-RGB-N
SW20: TAKE; PB26-13M-RGB; MPN PB26-13M-B-WT-RGB-N
SW21: CLEAR; PB26-13M-RGB; MPN PB26-13M-B-WT-RGB-N
SW22: ENTER; PB26-13M-RGB; MPN PB26-13M-B-WT-RGB-N
SW23: PLAY; PB26-13M-RGB; MPN PB26-13M-B-WT-RGB-N
SW24: LAST_CUE; PB26-13M-RGB; MPN PB26-13M-B-WT-RGB-N
SW25: MARK; PB26-13M-RGB; MPN PB26-13M-B-WT-RGB-N
SW26: RECORD; PB26-13M-RGB; MPN PB26-13M-B-WT-RGB-N
SW27: PRV_CTL; PB26-13M-RGB; MPN PB26-13M-B-WT-RGB-N
SW30: F1; TS5-9.2mm-LED; MPN TS5 yellow
SW31: F2; TS5-9.2mm-LED; MPN TS5 yellow
SW32: F3; TS5-9.2mm-LED; MPN TS5 yellow
SW33: F4; TS5-9.2mm-LED; MPN TS5 yellow
SW34: F5; TS5-9.2mm-LED; MPN TS5 yellow
SW35: F6; TS5-9.2mm-LED; MPN TS5 yellow
SW36: F7; TS5-9.2mm-LED; MPN TS5 yellow
SW37: F8; TS5-9.2mm-LED; MPN TS5 yellow
SW38: F9; TS5-9.2mm-LED; MPN TS5 yellow
SW39: F10; TS5-9.2mm-LED; MPN TS5 yellow
TP1: VBUS; TestPoint_Pad_D1.5mm
TP2: +5V; TestPoint_Pad_D1.5mm
TP3: +5V_LED; TestPoint_Pad_D1.5mm
TP4: +3V3; TestPoint_Pad_D1.5mm
TP5: +1V1; TestPoint_Pad_D1.5mm
TP6, TP7: GND; TestPoint_Pad_D1.5mm
TP10: I2C_SDA; TestPoint_Pad_D1.5mm
TP11: I2C_SCL; TestPoint_Pad_D1.5mm
TP12: LED_SDB; TestPoint_Pad_D1.5mm
TP13: BTN_INT; TestPoint_Pad_D1.5mm
U1: SRV05-4; SOT-23-6; MPN hongjiacheng SRV05-4; LCSC C7420376
U2: TLV76133DCYR; SOT-223-3_TabPin2; MPN TLV76133DCYR; LCSC C7527500
U3: RP2040; QFN-56-1EP_7x7mm_P0.4mm_EP3.2x3.2mm; LCSC C2040
U4: W25Q128JVSIQ; SOIC-8_5.3x5.3mm_P1.27mm; LCSC C97521
U5: W5500; LQFP-48_7x7mm_P0.5mm; LCSC C32843
U6, U7: IS31FL3236A; QFN-44-1EP_5x5mm_P0.4mm; MPN IS31FL3236A-QFLS2-TR; LCSC C246443
U8, U9: TCA9555RTWR; Texas_RTW_WQFN-24-1EP_4x4mm_P0.5mm_EP2.7x2.7mm; LCSC C140277
Y1: 12MHz; Crystal_SMD_3225-4Pin_3.2x2.5mm; MPN TX322512M4DBDE2T; LCSC C5310728
Y2: 25MHz; Crystal_SMD_3225-4Pin_3.2x2.5mm; MPN X322525MOB4SI (CL 12 pF); LCSC C9006

Connections:
+1V1: C19.1, C20.1, C21.1, TP5.1, U3.23 (DVDD), U3.45 (VREG_VOUT), U3.50 (DVDD)
+3V3: C6.1, C7.1, C10.1, C11.1, C12.1, C13.1, C14.1, C15.1, C16.1, C17.1, C18.1, C22.1, C25.1, C47.1, C56.1, C70.1, C71.1, C81.1, C83.1, FB2.1, J2.1, J3.2, J4.9, J4.12, J5.1, J6.1, R5.1, R12.1, R22.1, R23.1, R35.1, R43.1, R44.1, R50.1, R64.1, R65.1, R66.1, R72.1, R73.1, R74.1, RN1.5 (R4.2), RN1.6 (R3.2), RN1.7 (R2.2), RN1.8 (R1.2), RN2.5 (R4.2), RN2.6 (R3.2), RN2.7 (R2.2), RN2.8 (R1.2), RN3.5 (R4.2), RN3.6 (R3.2), RN3.7 (R2.2), RN3.8 (R1.2), RN4.5 (R4.2), RN4.6 (R3.2), RN4.7 (R2.2), RN4.8 (R1.2), RN5.5 (R4.2), RN5.6 (R3.2), RN5.7 (R2.2), RN5.8 (R1.2), RN6.5 (R4.2), RN6.6 (R3.2), RN6.7 (R2.2), RN6.8 (R1.2), RN7.5 (R4.2), RN7.6 (R3.2), RN7.7 (R2.2), RN7.8 (R1.2), TP4.1, U2.2 (VO), U3.1 (IOVDD), U3.10 (IOVDD), U3.22 (IOVDD), U3.33 (IOVDD), U3.42 (IOVDD), U3.43 (ADC_AVDD), U3.44 (VREG_VIN), U3.48 (USB_VDD), U3.49 (IOVDD), U4.8 (VCC), U5.28 (VDD), U5.43 (PMODE2), U5.44 (PMODE1), U5.45 (PMODE0), U8.21 (VCC), U9.18 (A0), U9.21 (VCC)
+3V3A: C40.1, C41.1, C42.1, C43.1, C44.1, C45.1, C46.1, FB2.2, R26.2, R27.2, R28.1, U5.4 (AVDD), U5.8 (AVDD), U5.11 (AVDD), U5.15 (AVDD), U5.17 (AVDD), U5.21 (AVDD)
+5V: C1.1, C2.1, D1.1 (K), F1.2, FB1.1, J3.1, R6.1, TP2.1, U2.3 (VI)
+5V_LED: C3.1, C4.1, C5.1, C60.1, C61.1, C62.1, C63.1, FB1.2, SW10.A (LED+), SW11.A (LED+), SW12.A (LED+), SW13.A (LED+), SW14.A (LED+), SW15.A (LED+), SW16.A (LED+), SW17.A (LED+), SW18.A (LED+), SW19.A (LED+), SW20.A (LED+), SW21.A (LED+), SW22.A (LED+), SW23.A (LED+), SW24.A (LED+), SW25.A (LED+), SW26.A (LED+), SW27.A (LED+), SW30.6 (LED+), SW31.6 (LED+), SW32.6 (LED+), SW33.6 (LED+), SW34.6 (LED+), SW35.6 (LED+), SW36.6 (LED+), SW37.6 (LED+), SW38.6 (LED+), SW39.6 (LED+), TP3.1, U6.38 (VCC), U7.37 (AD), U7.38 (VCC)
/BTN_BROWSE: RN2.4 (R4.1), SW17.2 (NO), U8.8 (P07)
/BTN_CAM_A: RN1.3 (R3.1), SW12.2 (NO), U8.3 (P02)
/BTN_CAM_B: RN1.4 (R4.1), SW13.2 (NO), U8.4 (P03)
/BTN_CAM_C: RN2.1 (R1.1), SW14.2 (NO), U8.5 (P04)
/BTN_CAM_D: RN2.2 (R2.1), SW15.2 (NO), U8.6 (P05)
/BTN_CLEAR: RN5.1 (R1.1), SW21.2 (NO), U9.1 (P00)
/BTN_ENTER: RN5.2 (R2.1), SW22.2 (NO), U9.2 (P01)
/BTN_F1: RN3.4 (R4.1), SW30.4 (S2), U8.13
/BTN_F2: RN4.1 (R1.1), SW31.4 (S2), U8.14
/BTN_F3: RN4.2 (R2.1), SW32.4 (S2), U8.15
/BTN_F4: RN4.3 (R3.1), SW33.4 (S2), U8.16
/BTN_F5: RN4.4 (R4.1), SW34.4 (S2), U8.17
/BTN_F6: RN6.4 (R4.1), SW35.4 (S2), U9.8 (P07)
/BTN_F7: RN7.1 (R1.1), SW36.4 (S2), U9.10
/BTN_F8: RN7.2 (R2.1), SW37.4 (S2), U9.11
/BTN_F9: RN7.3 (R3.1), SW38.4 (S2), U9.12
/BTN_F10: RN7.4 (R4.1), SW39.4 (S2), U9.13
/BTN_IN: RN3.1 (R1.1), SW18.2 (NO), U8.10
/BTN_INT: R50.2, TP13.1, U3.12 (GPIO9), U8.22 (~INT), U9.22 (~INT)
/BTN_LAST_CUE: RN5.4 (R4.1), SW24.2 (NO), U9.4 (P03)
/BTN_MARK: RN6.1 (R1.1), SW25.2 (NO), U9.5 (P04)
/BTN_MENU: RN1.1 (R1.1), SW10.2 (NO), U8.1 (P00)
/BTN_OUT: RN3.2 (R2.1), SW19.2 (NO), U8.11
/BTN_PLAY: RN5.3 (R3.1), SW23.2 (NO), U9.3 (P02)
/BTN_PLST: RN2.3 (R3.1), SW16.2 (NO), U8.7 (P06)
/BTN_PRV_CTL: RN6.3 (R3.1), SW27.2 (NO), U9.7 (P06)
/BTN_RECORD: RN6.2 (R2.1), SW26.2 (NO), U9.6 (P05)
/BTN_SHIFT: RN1.2 (R2.1), SW11.2 (NO), U8.2 (P01)
/BTN_TAKE: RN3.3 (R3.1), SW20.2 (NO), U8.12
/ETH_ACT_K: J4.10, R34.2
/ETH_CS: R35.2, U3.28 (GPIO17), U5.32 (~SCS)
/ETH_INT: R22.2, U3.32 (GPIO21), U5.36 (~INT)
/ETH_LINK_K: J4.11, R33.2
/ETH_MISO: U3.27 (GPIO16), U5.34 (MISO)
/ETH_MOSI: U3.30 (GPIO19), U5.35 (MOSI)
/ETH_RCT: C55.1, J4.5 (RCT), R31.2, R32.2
/ETH_RDN: C54.2, J4.6 (RD-)
/ETH_RDP: C53.2, J4.3 (RD+)
/ETH_RST: R23.2, U3.31 (GPIO20), U5.37 (~RST)
/ETH_RXN_T: C54.1, R30.2, R32.1
/ETH_RXP_T: C53.1, R29.2, R31.1
/ETH_SCK: U3.29 (GPIO18), U5.33 (SCLK)
/ETH_TCT: C52.1, J4.4 (TCT), R28.2
/ETH_TDN: J4.2 (TD-), R25.2, R27.1
/ETH_TDP: J4.1 (TD+), R24.2, R26.1
/EXP_P14: J3.11, U9.14
/EXP_P15: J3.12, U9.15
/EXP_P16: J3.13, U9.16
/EXP_P17: J3.14, U9.17
/GP10: J3.5, U3.13 (GPIO10)
/GP11: J3.6, U3.14 (GPIO11)
/GP22: J3.7, U3.34 (GPIO22)
/GP23: J3.8, U3.35 (GPIO23)
/GP24: J3.9, U3.36 (GPIO24)
/GP28: J3.10, U3.40 (GPIO28/ADC2)
/I2C_SCL: J3.16, R44.2, TP11.1, U3.9 (GPIO7), U6.42 (SCL), U7.42 (SCL), U8.19 (SCL), U9.19 (SCL)
/I2C_SDA: J3.15, R43.2, TP10.1, U3.8 (GPIO6), U6.41 (SDA), U7.41 (SDA), U8.20 (SDA), U9.20 (SDA)
/JOG_CLK: R70.1, U3.5 (GPIO3)
/JOG_CSN: R71.1, U3.6 (GPIO4)
/JOG_C_MODE: J6.3, R68.2
/JOG_C_OUT: J6.7, R75.1
/JOG_C_P6: J6.4, R69.2, R72.2
/JOG_C_P7: J6.5, R70.2, R73.2
/JOG_C_P8: J6.6, R71.2, R74.2
/JOG_DO: R69.1, U3.4 (GPIO2)
/JOG_MODE: R68.1, U3.7 (GPIO5)
/JOG_OUT: C82.1, R75.2, U3.39 (GPIO27/ADC1)
/LED_BROWSE_B: SW17.B (B-), U6.23 (OUT24)
/LED_BROWSE_G: SW17.G (G-), U6.22 (OUT23)
/LED_BROWSE_R: SW17.R (R-), U6.21 (OUT22)
/LED_CAM_A_B: SW12.B (B-), U6.7 (OUT9)
/LED_CAM_A_G: SW12.G (G-), U6.6 (OUT8)
/LED_CAM_A_R: SW12.R (R-), U6.5 (OUT7)
/LED_CAM_B_B: SW13.B (B-), U6.10 (OUT12)
/LED_CAM_B_G: SW13.G (G-), U6.9 (OUT11)
/LED_CAM_B_R: SW13.R (R-), U6.8 (OUT10)
/LED_CAM_C_B: SW14.B (B-), U6.13 (OUT15)
/LED_CAM_C_G: SW14.G (G-), U6.12 (OUT14)
/LED_CAM_C_R: SW14.R (R-), U6.11 (OUT13)
/LED_CAM_D_B: SW15.B (B-), U6.16 (OUT18)
/LED_CAM_D_G: SW15.G (G-), U6.15 (OUT17)
/LED_CAM_D_R: SW15.R (R-), U6.14 (OUT16)
/LED_CLEAR_B: SW21.B (B-), U7.1 (OUT3)
/LED_CLEAR_G: SW21.G (G-), U7.44 (OUT2)
/LED_CLEAR_R: SW21.R (R-), U7.43 (OUT1)
/LED_ENTER_B: SW22.B (B-), U7.4 (OUT6)
/LED_ENTER_G: SW22.G (G-), U7.3 (OUT5)
/LED_ENTER_R: SW22.R (R-), U7.2 (OUT4)
/LED_F1: SW30.5 (LED-), U7.21 (OUT22)
/LED_F2: SW31.5 (LED-), U7.22 (OUT23)
/LED_F3: SW32.5 (LED-), U7.23 (OUT24)
/LED_F4: SW33.5 (LED-), U7.24 (OUT25)
/LED_F5: SW34.5 (LED-), U7.25 (OUT26)
/LED_F6: SW35.5 (LED-), U7.26 (OUT27)
/LED_F7: SW36.5 (LED-), U7.27 (OUT28)
/LED_F8: SW37.5 (LED-), U7.28 (OUT29)
/LED_F9: SW38.5 (LED-), U7.29 (OUT30)
/LED_F10: SW39.5 (LED-), U7.30 (OUT31)
/LED_IN_B: SW18.B (B-), U6.26 (OUT27)
/LED_IN_G: SW18.G (G-), U6.25 (OUT26)
/LED_IN_R: SW18.R (R-), U6.24 (OUT25)
/LED_LAST_CUE_B: SW24.B (B-), U7.10 (OUT12)
/LED_LAST_CUE_G: SW24.G (G-), U7.9 (OUT11)
/LED_LAST_CUE_R: SW24.R (R-), U7.8 (OUT10)
/LED_MARK_B: SW25.B (B-), U7.13 (OUT15)
/LED_MARK_G: SW25.G (G-), U7.12 (OUT14)
/LED_MARK_R: SW25.R (R-), U7.11 (OUT13)
/LED_MENU_B: SW10.B (B-), U6.1 (OUT3)
/LED_MENU_G: SW10.G (G-), U6.44 (OUT2)
/LED_MENU_R: SW10.R (R-), U6.43 (OUT1)
/LED_OUT_B: SW19.B (B-), U6.29 (OUT30)
/LED_OUT_G: SW19.G (G-), U6.28 (OUT29)
/LED_OUT_R: SW19.R (R-), U6.27 (OUT28)
/LED_PLAY_B: SW23.B (B-), U7.7 (OUT9)
/LED_PLAY_G: SW23.G (G-), U7.6 (OUT8)
/LED_PLAY_R: SW23.R (R-), U7.5 (OUT7)
/LED_PLST_B: SW16.B (B-), U6.20 (OUT21)
/LED_PLST_G: SW16.G (G-), U6.19 (OUT20)
/LED_PLST_R: SW16.R (R-), U6.18 (OUT19)
/LED_PRV_CTL_B: SW27.B (B-), U7.20 (OUT21)
/LED_PRV_CTL_G: SW27.G (G-), U7.19 (OUT20)
/LED_PRV_CTL_R: SW27.R (R-), U7.18 (OUT19)
/LED_RECORD_B: SW26.B (B-), U7.16 (OUT18)
/LED_RECORD_G: SW26.G (G-), U7.15 (OUT17)
/LED_RECORD_R: SW26.R (R-), U7.14 (OUT16)
/LED_SDB: R42.1, TP12.1, U3.11 (GPIO8), U6.36 (~SDB), U7.36 (~SDB)
/LED_SHIFT_B: SW11.B (B-), U6.4 (OUT6)
/LED_SHIFT_G: SW11.G (G-), U6.3 (OUT5)
/LED_SHIFT_R: SW11.R (R-), U6.2 (OUT4)
/LED_TAKE_B: SW20.B (B-), U6.32 (OUT33)
/LED_TAKE_G: SW20.G (G-), U6.31 (OUT32)
/LED_TAKE_R: SW20.R (R-), U6.30 (OUT31)
/LEV_CLK: R62.1, U3.17 (GPIO14)
/LEV_CSN: R63.1, U3.16 (GPIO13)
/LEV_C_MODE: J5.3, R60.2
/LEV_C_OUT: J5.7, R67.1
/LEV_C_P6: J5.4, R61.2, R64.2
/LEV_C_P7: J5.5, R62.2, R65.2
/LEV_C_P8: J5.6, R63.2, R66.2
/LEV_DO: R61.1, U3.15 (GPIO12)
/LEV_MODE: R60.1, U3.18 (GPIO15)
/LEV_OUT: C80.1, R67.2, U3.38 (GPIO26/ADC0)
/QSPI_SCLK: U3.52 (QSPI_SCLK), U4.6 (CLK)
/QSPI_SD0: U3.53 (QSPI_SD0), U4.5 (DI/IO_{0})
/QSPI_SD1: U3.55 (QSPI_SD1), U4.2 (DO/IO_{1})
/QSPI_SD2: U3.54 (QSPI_SD2), U4.3 (~WP/IO_{2})
/QSPI_SD3: U3.51 (QSPI_SD3), U4.7 (~HOLD/~RESET/IO_{3})
/QSPI_SS: R11.1, U3.56 (~QSPI_SS), U4.1 (~CS)
/RUN: J2.5, R12.2, SW2.1, U3.26 (RUN)
/STATUS_LED: R13.1, U3.37 (GPIO25)
/SWCLK: J2.2, U3.24 (SWCLK)
/SWDIO: J2.3, U3.25 (SWDIO)
/UART_RX: J2.7, U3.3 (GPIO1)
/UART_TX: J2.6, U3.2 (GPIO0)
/USB_CC1: J1.A5 (CC1), R1.1
/USB_CC2: J1.B5 (CC2), R2.1
/USB_CONN_DM: J1.A7 (D-), J1.B7 (D-), R4.1, U1.3 (IO2), U1.6 (IO4)
/USB_CONN_DP: J1.A6 (D+), J1.B6 (D+), R3.1, U1.1 (IO1), U1.4 (IO3)
/USB_DM: R4.2, U3.46 (USB_DM)
/USB_DP: R3.2, U3.47 (USB_DP)
/VSENSE_5V: C8.1, R6.2, R7.1, U3.41 (GPIO29/ADC3)
/W_1V2O: C49.1, U5.22 (1V2O)
/W_ACTLED: R34.1, U5.27 (ACTLED)
/W_EXRES: R20.1, U5.10 (EXRES1)
/W_LINKLED: R33.1, U5.25 (LINKLED)
/W_RXN: R30.1, U5.5 (RXN)
/W_RXP: R29.1, U5.6 (RXP)
/W_TOCAP: C48.1, U5.20 (TOCAP)
/W_TXN: R25.1, U5.1 (TXN)
/W_TXP: R24.1, U5.2 (TXP)
/W_XI: C50.1, R21.1, U5.30 (XI/CLKIN), Y2.1
/W_XO: C51.1, R21.2, U5.31 (XO), Y2.3
/XIN: C23.1, U3.20 (XIN), Y1.1
/XOUT: R10.1, U3.21 (XOUT)
/XTAL_OUT: C24.1, R10.2, Y1.3
GND: C1.2, C2.2, C3.2, C4.2, C5.2, C6.2, C7.2, C8.2, C10.2, C11.2, C12.2, C13.2, C14.2, C15.2, C16.2, C17.2, C18.2, C19.2, C20.2, C21.2, C22.2, C23.2, C24.2, C25.2, C40.2, C41.2, C42.2, C43.2, C44.2, C45.2, C46.2, C47.2, C48.2, C49.2, C50.2, C51.2, C52.2, C55.2, C56.2, C60.2, C61.2, C62.2, C63.2, C70.2, C71.2, C80.2, C81.2, C82.2, C83.2, D1.2 (A), D2.1 (K), D3.1 (K), J1.A1 (GND), J1.A12 (GND), J1.B1 (GND), J1.B12 (GND), J1.S1 (SHIELD), J2.4, J3.3, J3.4, J4.8, J4.SH, J5.2, J5.8, J5.MP (MountPin), J6.2, J6.8, J6.MP (MountPin), R1.2, R2.2, R7.2, R36.2, R40.2, R41.2, R42.2, SW1.2, SW2.2, SW10.1 (COM), SW11.1 (COM), SW12.1 (COM), SW13.1 (COM), SW14.1 (COM), SW15.1 (COM), SW16.1 (COM), SW17.1 (COM), SW18.1 (COM), SW19.1 (COM), SW20.1 (COM), SW21.1 (COM), SW22.1 (COM), SW23.1 (COM), SW24.1 (COM), SW25.1 (COM), SW26.1 (COM), SW27.1 (COM), SW30.1 (S1), SW31.1 (S1), SW32.1 (S1), SW33.1 (S1), SW34.1 (S1), SW35.1 (S1), SW36.1 (S1), SW37.1 (S1), SW38.1 (S1), SW39.1 (S1), TP6.1, TP7.1, U1.2 (VN), U2.1 (GND), U3.19 (TESTEN), U3.57 (GND), U4.4 (GND), U5.3 (AGND), U5.9 (AGND), U5.14 (AGND), U5.16 (AGND), U5.19 (AGND), U5.23 (RSVD), U5.29 (GND), U5.38 (RSVD), U5.39 (RSVD), U5.40 (RSVD), U5.41 (RSVD), U5.42 (RSVD), U5.48 (AGND), U6.17 (GND), U6.37 (AD), U6.39 (GND), U6.45 (EP), U7.17 (GND), U7.39 (GND), U7.45 (EP), U8.9 (GND), U8.18 (A0), U8.23 (A1), U8.24 (A2), U8.25 (EPAD), U9.9 (GND), U9.23 (A1), U9.24 (A2), U9.25 (EPAD), Y1.2 (G), Y1.4 (G), Y2.2 (G), Y2.4 (G); also elsewhere on the board
unnamed: D2.2 (A), R5.2
unnamed: D3.2 (A), R13.2
unnamed: R11.2, SW1.1
unnamed: R20.2, R36.1
unnamed: R40.1, U6.40 (R_EXT)
unnamed: R41.1, U7.40 (R_EXT)
VBUS: F1.1, J1.A4 (VBUS), J1.A9 (VBUS), J1.B4 (VBUS), J1.B9 (VBUS), TP1.1, U1.5 (VP)

Notes on the sheet:
1 USB-C, ochrana a napájení 5 V / 3,3 V
USB-C bez PD (2x 5,1k na CC). Polyswitch 0,75 A, TVS 5 V. +5V_LED napájí anody tlačítek a budiče LED přes ferit. LDO LDL1117S33R: úbytek < 0,3 V při 200 mA. Celkový odběr (jas LED) omezuje firmware pod 500 mA.
2 MCU RP2040
GPIO: viz PINMAP.md. SPI0 = W5500 (jako W5500-EVB-Pico), I2C1 = LED budiče + expandéry, SPI1 = páka (MT6701 SSI), GP2-4 = jog (MT6701 SSI přes PIO, příp. ABZ), GP29 = měření 5 V.
IOVDD x6, ADC_AVDD, USB_VDD, VREG_VIN, bulk
VREG_VOUT, DVDD x2
4 Ethernet W5500 + RJ45 HR911105A (vMix TCP API)
Analogová část podle referenčního zapojení WIZnet: 33R v sérii, 49,9R terminace na +3V3A, 6,8nF vazba RX, středy vinutí přes 10R/22nF a 10nF. TOCAP 4,7uF, 1V2O 10nF.
3 Flash, BOOTSEL, RESET, stavová LED
5 Budiče LED 2x IS31FL3236A (I2C, 22 kHz PWM, bez multiplexu)
I_MAX = 58,5 x 1,3 V / R_EXT = 16,2 mA (4,7k, LED v tlačítkách max. 20 mA). U6 adresa 0x3C (AD=GND), U7 0x3F (AD=VCC). VCC = 5 V, protože OUTx nesmí přesáhnout VCC + 0,3 V (anody LED jsou na 5 V). SDB stažený k zemi = LED po startu zhasnuté.
6 Expandéry tlačítek 2x TCA9555 (I2C)
U8 adresa 0x20, U9 0x21. Vstupy mají interní pull-up 100k, tlačítko spíná proti GND. INT (open drain) společný pro oba, pull-up R50. Volné vstupy U9 P14-P17 jsou na konektoru J3.
7 Tlačítka panelu: 18x PB26-13M RGB, 10x TS5 se žlutou LED (ruční pájení)
Spínač: COM = GND, NO = vstup expandéru. LED: společná anoda na +5V_LED, katody na kanály IS31FL3236A.
8 Konektory senzorů páky a jogu (destičky s MT6701, JST-PH 8 pin)
Pin 3 MODE přepíná ABZ / I2C+SSI. P6 = A/SDA/DO, P7 = B/SCL/CLK, P8 = Z/CSN, OUT = analog do ADC (záloha).
9 Ladění a rozšíření
J2 SWD + UART (osadit při ladění). J3 rezervní GPIO, I2C, volné vstupy.

Board: 4 copper layers, 176 parts (5 on the bottom side), 188 nets, no tracks yet.

Other parts of the board:
H1, H2, H3, H4: M3; MountingHole_3.2mm_M3_Pad_Via

Their connections:
GND: H1.1, H2.1, H3.1, H4.1; also elsewhere on the board
