ItIsNotImportant-02/VMix-Replay-Controller/(commit log)

2026-11-11 Add project plan, dashboard source and first Deep Research prompt
    Phased plan for the EVS-like vMix replay controller (research, architecture,
    KiCad, PCB, JLCPCB, firmware, vMix setup, mechanics, bring-up), the dashboard
    page source and the Gemini Deep Research prompt #1 on the vMix API.
    Claude-Session: https://claude.ai/code/session_01G9p6qX9uCDFSwZPZQW8Pp6
2026-11-11 Add PB26-13M RGB button notes and design implications
    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
2026-11-11 Record decisions: 15 buttons, non-motorised lever with calibration, USB-C power
    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
2026-11-11 ADR-001: Ethernet to vMix TCP API, USB-C for power and service
    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
2026-11-11 Layout v0.3: F1-F10 as TS5 9.2 mm keys, 15 PB26 RGB elsewhere
    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
2026-11-11 Layout v0.5: camera keys left above the lever, MENU/SHIFT names, EVS reference photo
    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
2026-11-11 Add specification v1 draft with button map
    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
2026-11-11 Plan: no breadboard prototype, design for verification on the final board
    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
2026-11-11 Hardware: generated KiCad 9 schematic (power, MCU, Ethernet, LED drivers, buttons, inputs, sensors)
    Schematic is generated from tools/circuit.py by tools/gen.py; ERC passes with
    no violations. Adds project footprints for PB26, TS5 (placeholder) and
    IS31FL3236A QFN-44, DESIGN.md and generated PINMAP.md.
    Claude-Session: https://claude.ai/code/session_01G9p6qZU4tCLLDozXe19qJQ
    [buttons.kicad_sch, ethernet.kicad_sch, inputs.kicad_sch, leds.kicad_sch, mcu.kicad_sch, power.kicad_sch, sensors.kicad_sch, vmix-replay-controller.kicad_sch]
2026-11-11 Hardware: PCB placement script, LED/button mapping by board area, QFN-44 corner clearance
    tools/pcb.py builds the 4-layer board from the netlist: outline with lever
    notch and jog bearing hole, buttons at layout v0.5 positions, edge connectors
    on the rear edge, passives auto-placed next to the pads they serve, GND and
    +5V_LED planes, and exports a Specctra DSN for autorouting.
    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
    [buttons.kicad_sch, inputs.kicad_sch, leds.kicad_sch]
2026-11-11 Hardware: add placed (unrouted) 4-layer board
    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
    [vmix-replay-controller.kicad_pcb]
2026-11-11 Schéma překreslené na jednu stránku A2 rozdělenou do bloků
    Nový kreslicí engine (tools/schdraw.py + tools/layout.py) místo hierarchických listů
    s jednou součástkou na pin. verify.py porovnává netlist z KiCadu s circuit.py, ERC je čistý.
    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
    [vmix-replay-controller.kicad_sch]
2026-11-11 Odstraněné staré listy hierarchického schématu
    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
    [buttons.kicad_sch, ethernet.kicad_sch, inputs.kicad_sch, leds.kicad_sch, mcu.kicad_sch, power.kicad_sch, sensors.kicad_sch]
2026-11-11 Krystal RP2040 podle Hardware design with RP2040 (ABM8-272-T3, 2x 15 pF), stavová LED 220R
    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
    [vmix-replay-controller.kicad_sch]
2026-11-11 Ethernet podle datasheetu W5500: LED HR911105A podle polarity symbolu, 330R; FB1 na 2A ferit; poznámky k layoutu
    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
    [vmix-replay-controller.kicad_sch]
2026-11-11 W5500: druhý 10 uF na +3V3 podle reference WIZnet
    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
    [vmix-replay-controller.kicad_sch]
2026-11-11 Ethernet 1:1 podle WIZ850io a výkresu HR911105A: 3,3R série, krystal 18 pF, pull-up na CS
    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
    [vmix-replay-controller.kicad_sch]
2026-11-11 QFN-44 footprint IS31FL3236A podle land patternu z datasheetu Rev. I
    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
2026-11-11 Tlačítka: externí pull-upy 4,7k (RN1-RN7), R_EXT 4,7k (max. 16 mA na LED)
    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
    [vmix-replay-controller.kicad_sch]
2026-11-11 Senzory MT6701 ověřeny: jog přes SSI (PIO) místo ABZ, přejmenované sítě JOG_DO/CLK/CSN
    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
    [vmix-replay-controller.kicad_sch]
2026-11-11 Deska aktualizována z jednostránkového schématu (0 chyb DRC, 0 rozdílů proti schématu)
    Pravidla JLCPCB a třídy sítí uložené do .kicad_pro (KiCad 9 je v desce nedrží),
    domovské pozice pro RN1-RN7 a W5500 pasivy podle LAYOUT-NOTES.
    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
    [vmix-replay-controller.kicad_pcb]
2026-11-11 Všechna LCSC čísla ověřená na JLCPCB, export BOM/CPL s opravami rotací
    - doplněno 19 chybějících LCSC čísel (Basic, kde existuje), LED XINGLIGHT, RN UNI-ROYAL C1980
    - D2 napájená z +5V (Vf zelené InGaN ~2,6 V při 2 mA)
    - tools/jlc.py: BOM + CPL pro JLCPCB bez KiCadu, rotace a počátky odvozené z footprintů EasyEDA
    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
    [vmix-replay-controller.kicad_pcb, vmix-replay-controller.kicad_sch]
2026-11-11 Méně Extended dílů na JLCPCB: 17 -> 8 typů
    - 12,4k = 10k + 2,4k, 3,3R -> 0R, LED červená/žlutá Basic/Preferred
    - SRV05-4 místo USBLC6, SMF5.0A Preferred, FB1 BLM18PG121SN1D (Basic, 2 A)
    - RJ45 a JST konektory ručně (mimo BOM)
    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
    [vmix-replay-controller.kicad_pcb, vmix-replay-controller.kicad_sch]
2026-11-11 Revize podle datasheetů a fór: LDO TLV76133 (stabilní s keramikou), poznámky pro firmware
    LDL1117 vyžaduje minimální ESR výstupního C (obr. 20/21), s ~30 uF MLCC na +3V3
    by byl na hraně stability. TLV76133DCYR má stejný pinout a footprint.
    Doplněny poznámky: XOSC delay, TCA9555 kontrola konfigurace, IS31 shutdown,
    MT6701 SSI zarovnání, W5500 PHYCFGR, nákup originálního RJ45.
    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
    [vmix-replay-controller.kicad_pcb, vmix-replay-controller.kicad_sch]
2026-11-12 Menší deska: 202 x 142 mm místo 242 x 182 (-35 % plochy)
    USB-C na levé, RJ45 na pravé boční hraně, nové montážní otvory, W5500 a LDO
    přesunuté ke konektorům. DRC 0, shoda se schématem.
    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
    [vmix-replay-controller.kicad_pcb]
2026-11-12 Variant study: main board + small USB/Ethernet board, both 2-layer (not the main design)
    pcb.py: layer count, netlist, output and edge connectors are module settings.
    jlc.py: optional output directory.
    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
    [vmix-replay-controller.kicad_pcb]
2026-11-12 Variant study: narrow single board with the EVS LSM VIA key order, USB-C and RJ45 on the rear edge
    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
2026-11-12 Variant study LSM 2: 3.7 mm gaps between keys, right block raised as on the LSM VIA
    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
2026-11-12 Variant study LSM 3: camera row moved left over the lever, CAM D half over the column; drop variant 2
    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
2026-11-12 LSM 3 variant: hand-soldered connectors (RJ45, sensor JSTs, headers) on the bottom side
    pcb.py: BOTTOM set flips parts; SMD bottom parts don't block the top side.
    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
    [pcb.py]
2026-11-12 Switch the main board to layout v0.6 (EVS LSM VIA order), 160 x 155 mm, 4 layers
    Rear row MENU SHIFT USB-C RJ45 CLEAR ENTER, F1-F10 full width, cameras above the lever with
    CAM D half over the PLST..TAKE column, 3.7 mm gaps between PB26 keys. Hand-soldered connectors
    (RJ45, sensor JSTs, headers) on the bottom side; USB-C stays on top for JLC assembly.
    Variant scripts removed (in history). Panel drawing v0.6 (svg + 1:1 pdf), docs updated.
    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
    [vmix-replay-controller.kicad_pcb]
2026-11-12 Independent circuit review: TS5 footprint per the manufacturer drawing, diagonal switch pins, Y1 replacement
    - TS5: LED pads per Honyone drawing (6 = + left, 5 = - right), '+' mark, switch wired on pins 1 and 4 only
    - Y1: ABM8-272-T3 out of stock at JLC -> TX322512M4DBDE2T (C5310728, same CL 10 pF)
    - DESIGN.md: real TLV761 dropout, MT6701 MODE polarity, firmware notes, review summary
    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
    [vmix-replay-controller.kicad_pcb, vmix-replay-controller.kicad_sch]
2026-11-13 PB26 footprint cross-checked against the owner's FB26_RGB footprint
    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
2026-11-13 PB26: mechanical fit confirmed on the owner's earlier board
    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
